Safecast/bGeigieCast/images/quick_start_guide/module_config_mode_led.png

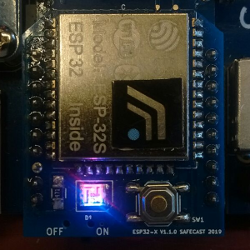
images/quick_start_guide/module_config_mode_led.png
