Safecast/bGeigieCast/images/quick_start_guide/module_initialized_led.png

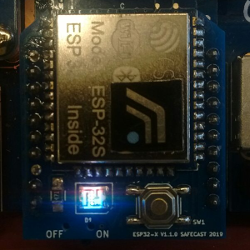
images/quick_start_guide/module_initialized_led.png
