Safecast/bGeigieCast/README.md

# bGeigieCast

An extension module to use your mobile bGeigieNano as a fixed sensor! 

User manual and other documentation on the Github Wiki:

* [User manual](https://github.com/Safecast/bGeigieCast/wiki/User-manual)
* [Quick start guide](https://github.com/Safecast/bGeigieCast/wiki/Quick-start-guide)
* [Set up your development environment](https://github.com/Safecast/bGeigieCast/wiki/Development-environment)
