Safecast/bGeigieCast/designs/hardware/bGeigieCast V1.6.0(StampS3)/bGeigieCast V1.6.0(StampS3)/Misc 3d files/m5-stamp-pico-1.snapshot.21/m5-stamp-pico-explode.png

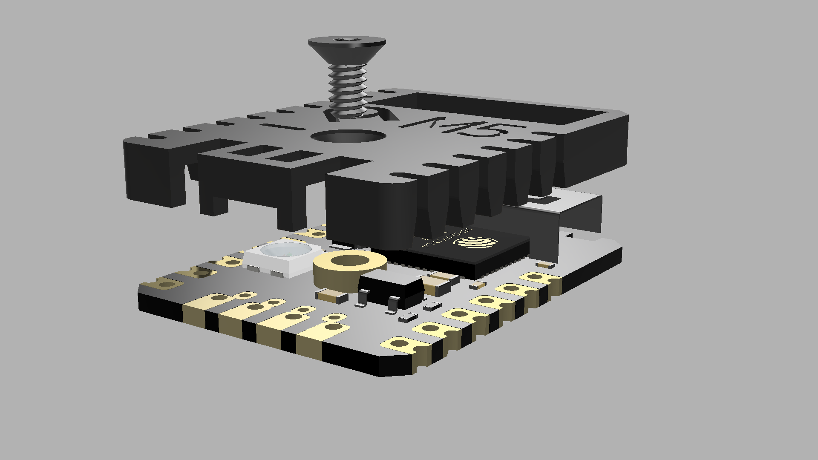
designs/hardware/bGeigieCast V1.6.0(StampS3)/bGeigieCast V1.6.0(StampS3)/Misc 3d files/m5-stamp-pico-1.snapshot.21/m5-stamp-pico-explode.png
