Safecast/bGeigieCast/designs/hardware/bGeigieCast V1.6.0(StampS3)/bGeigieCast V1.6.0(StampS3)/Misc 3d files/m5stamp-c3-1.snapshot.3/M5Stamp-C3.JPG

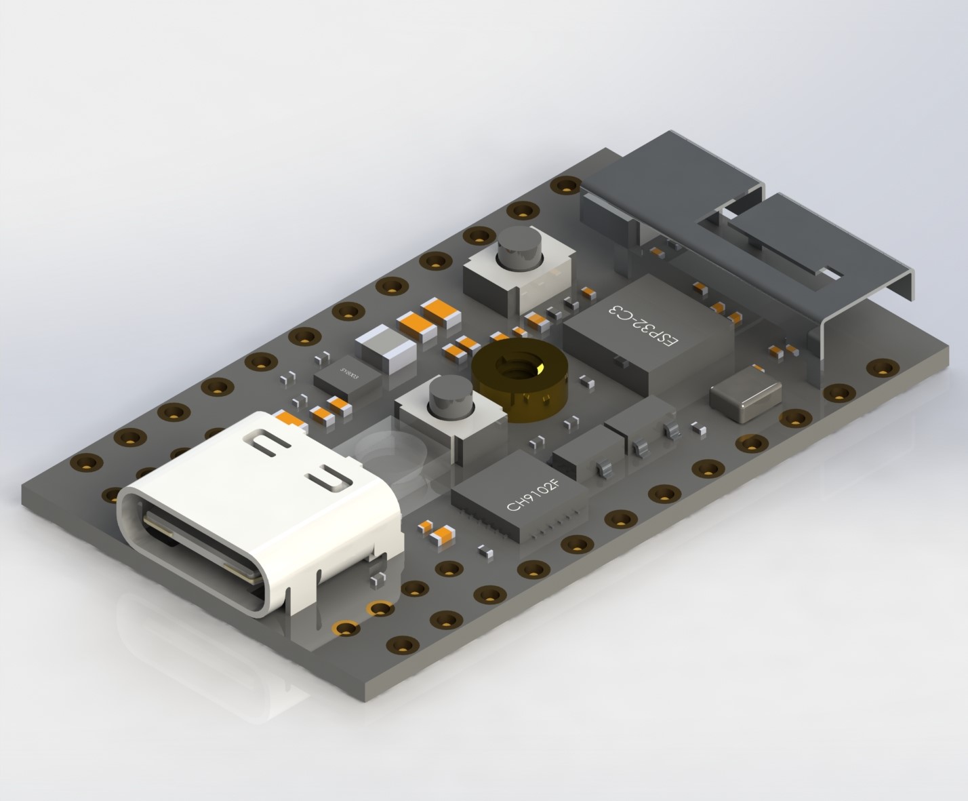
designs/hardware/bGeigieCast V1.6.0(StampS3)/bGeigieCast V1.6.0(StampS3)/Misc 3d files/m5stamp-c3-1.snapshot.3/M5Stamp-C3.JPG
