Safecast/bGeigieCast/designs/hardware/bGeigieCast V1.6.0(StampS3)/bGeigieCast V1.6.0(StampS3)/Misc 3d files/m5stamp-c3-1.snapshot.3/Schematic, M5Stamp C3.PNG

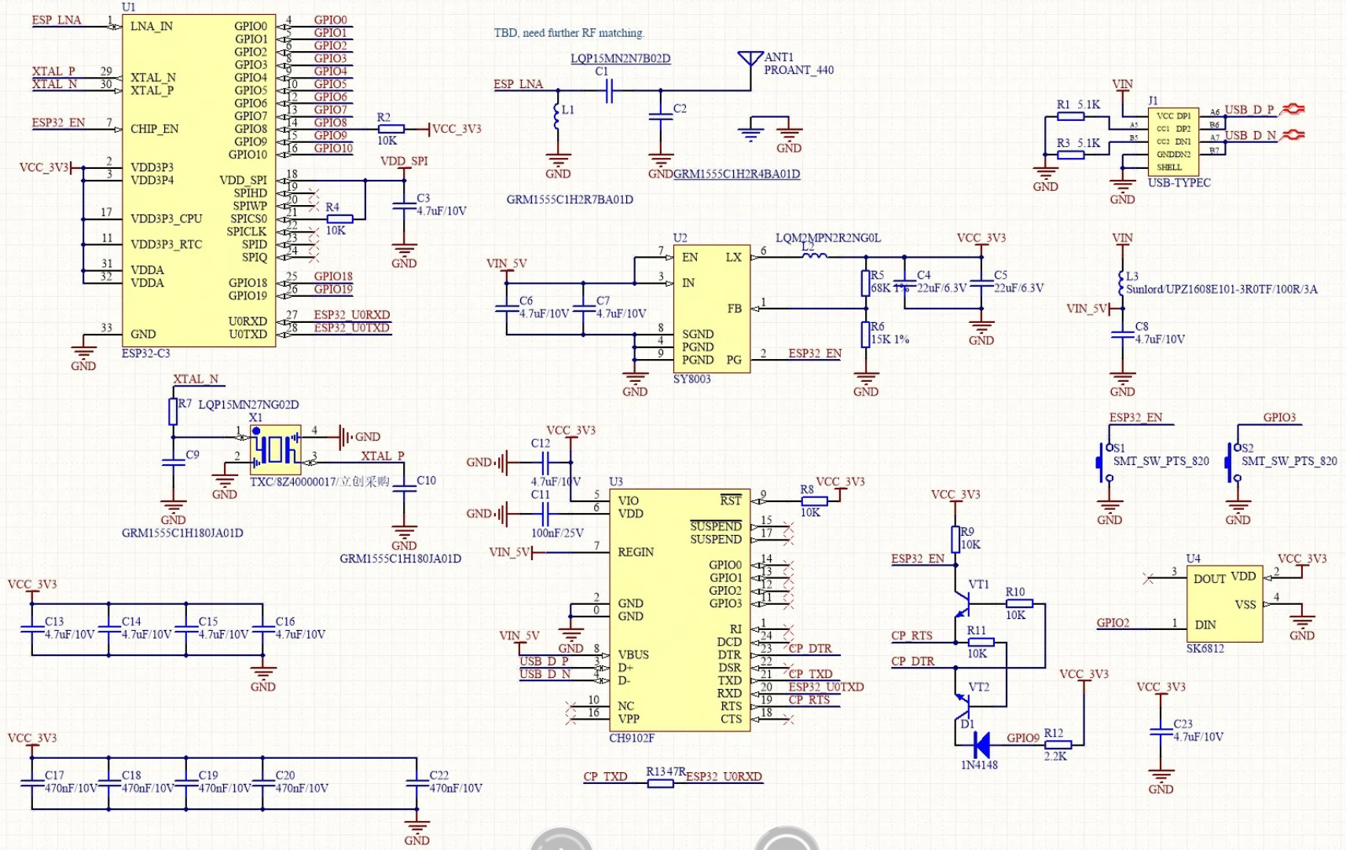
designs/hardware/bGeigieCast V1.6.0(StampS3)/bGeigieCast V1.6.0(StampS3)/Misc 3d files/m5stamp-c3-1.snapshot.3/Schematic, M5Stamp C3.PNG
