Safecast/bGeigieCast/designs/software/api-connector-states.png

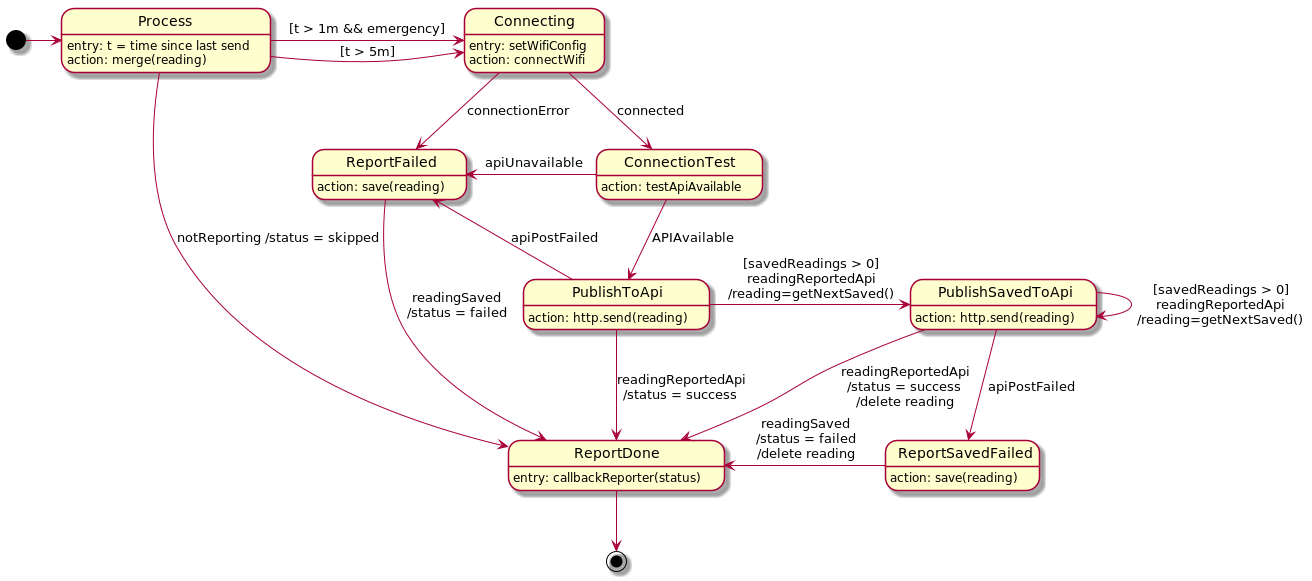
designs/software/api-connector-states.png
