Safecast/bGeigieCast/designs/software/controller-states.png

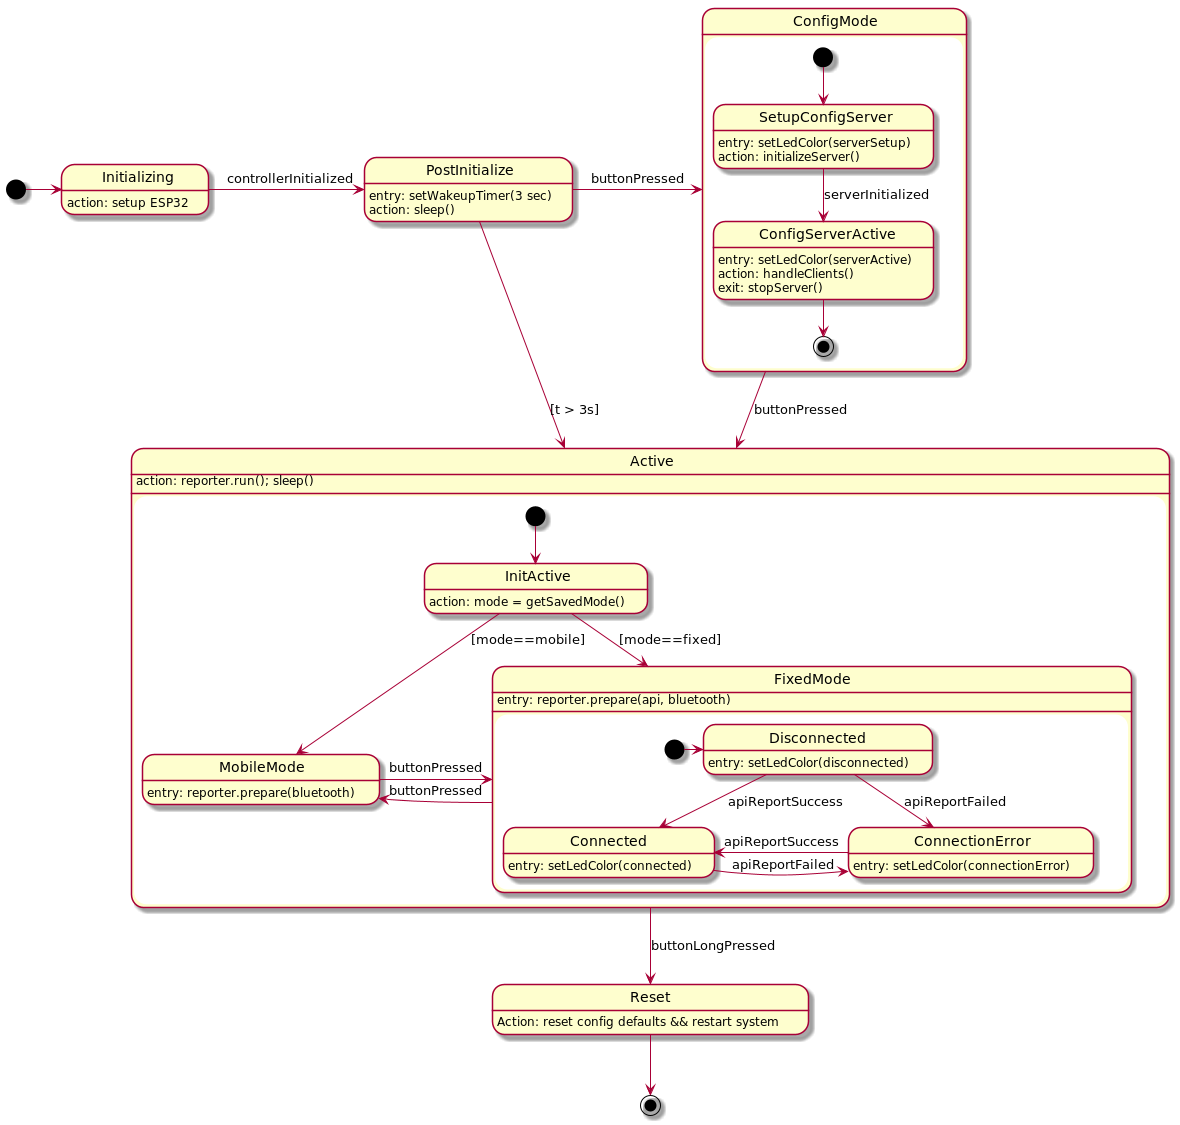
designs/software/controller-states.png
