Safecast/bGeigieCast/designs/software/process-data.png

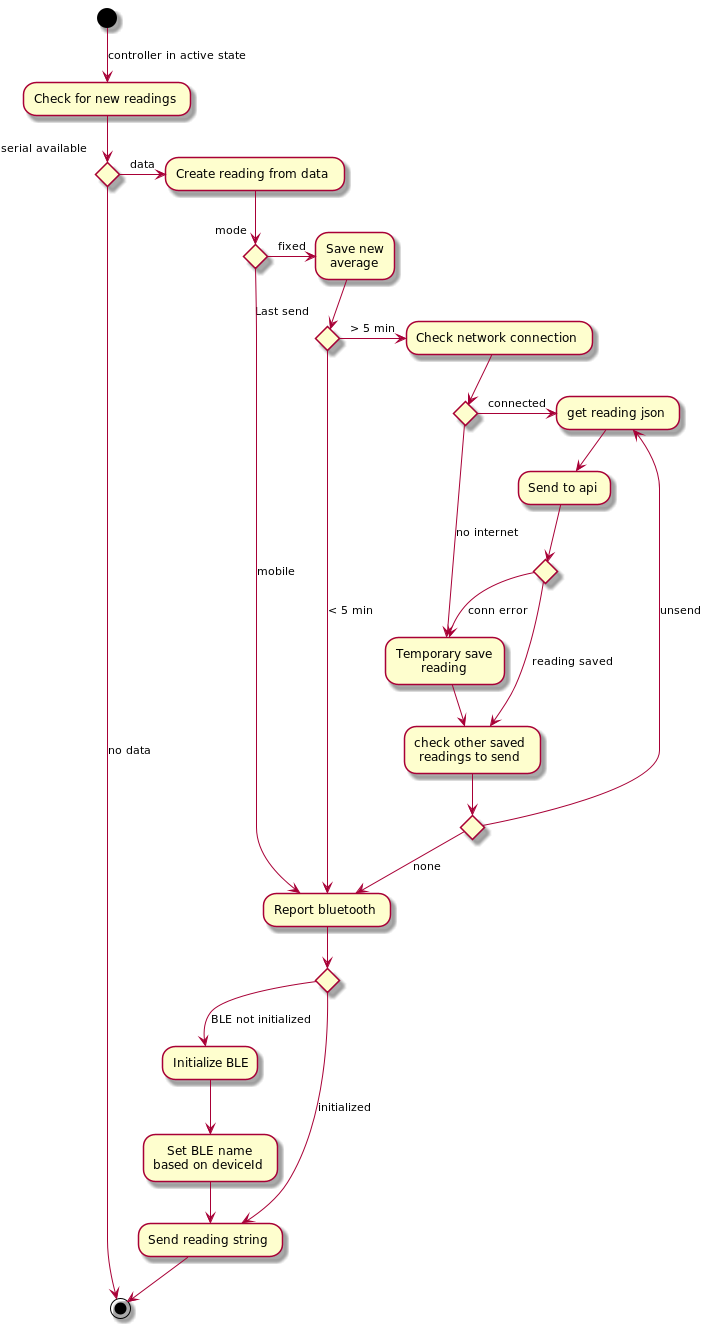
designs/software/process-data.png
