Safecast/bGeigieCast/designs/software/reporter-states.png

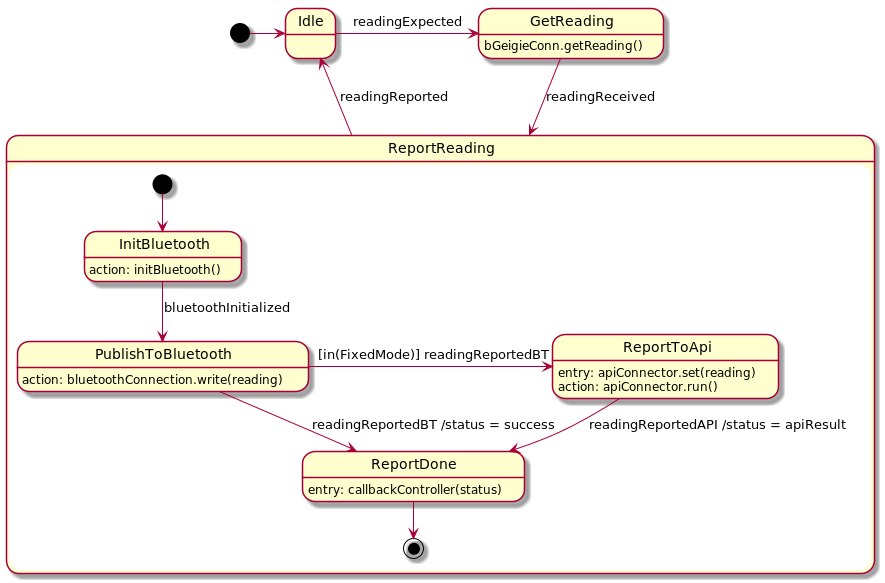
designs/software/reporter-states.png
