Safecast/bGeigieCast/designs/software/usecase.png

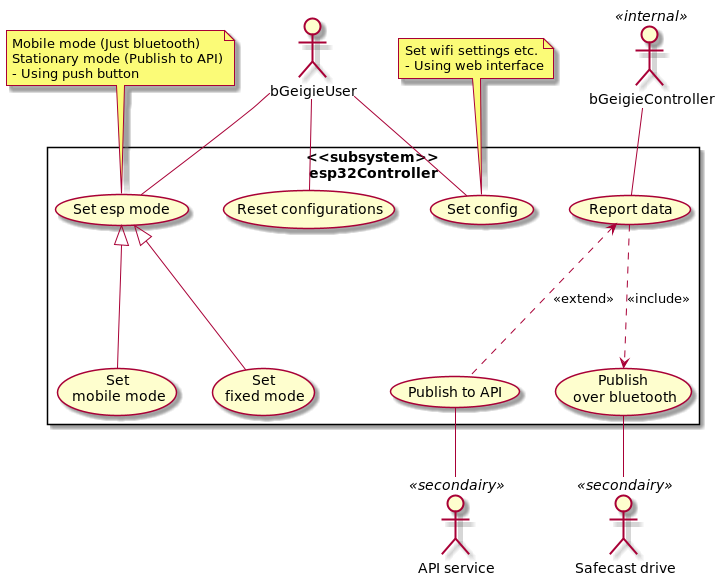
designs/software/usecase.png
