Safecast/bGeigieCast/images/module/LED-error.png

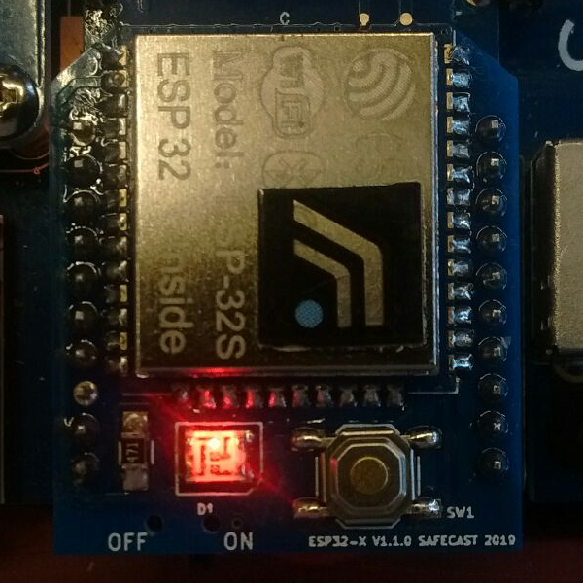
images/module/LED-error.png
