Safecast/bGeigieCast/images/module/mode-flow.png

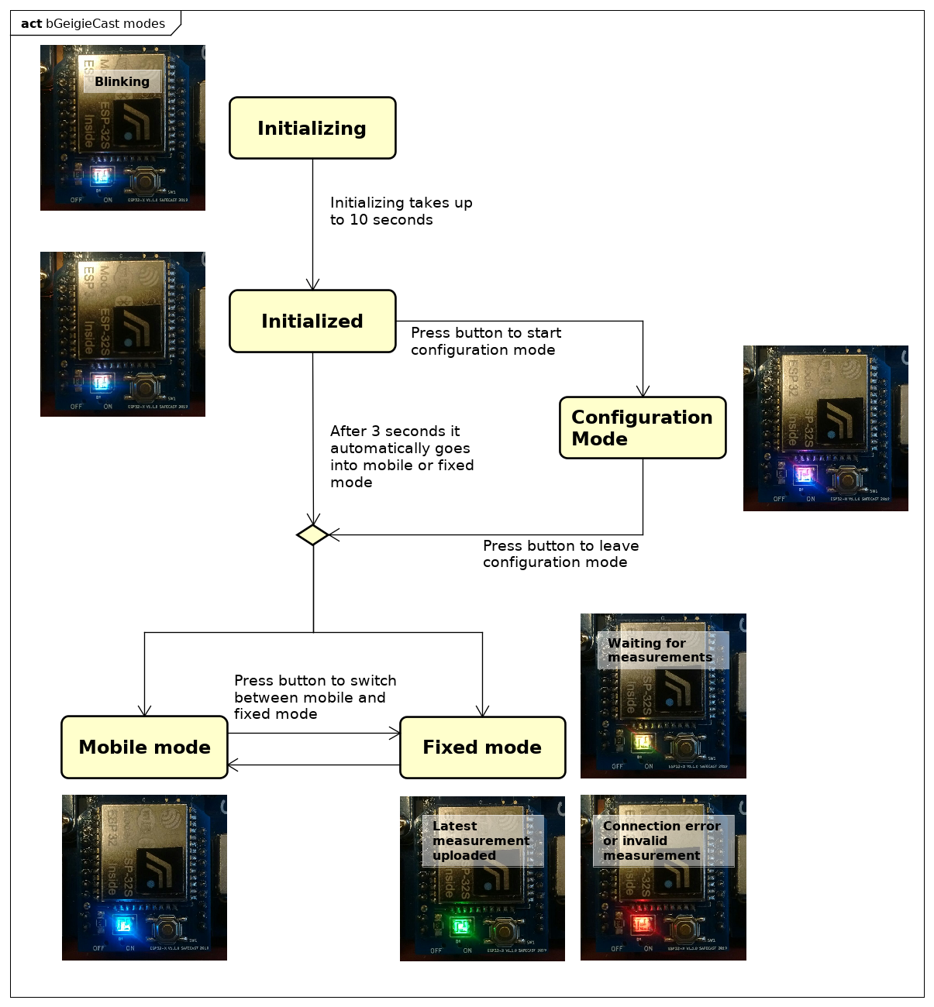
images/module/mode-flow.png
