Safecast/bGeigieCast/images/module/module.png

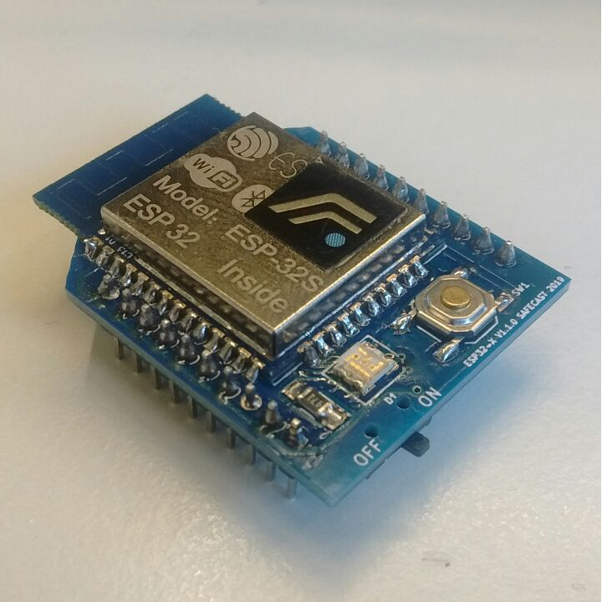
images/module/module.png
