Safecast/bGeigieCast/images/wiki/wireless charger dock.jpg

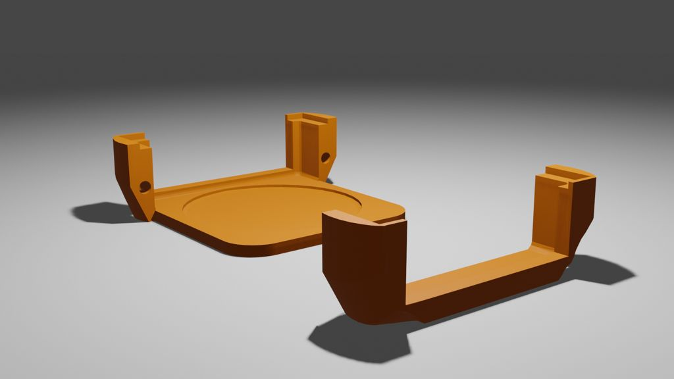
images/wiki/wireless charger dock.jpg
