Safecast/bGeigieCast/images/wiki/xbee_adapter.jpeg

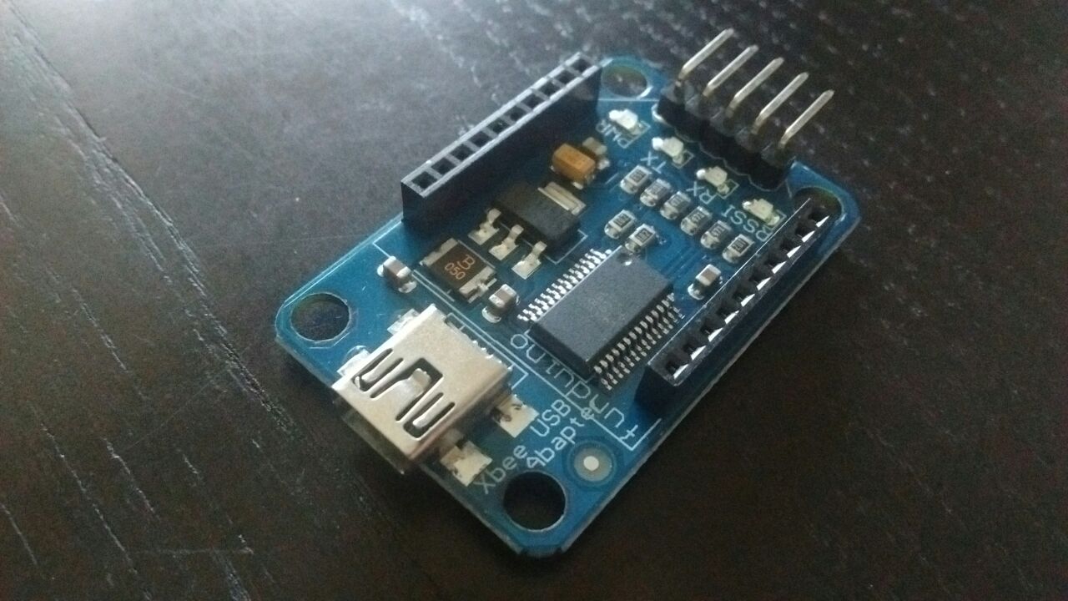
images/wiki/xbee_adapter.jpeg
