Safecast/bGeigieCast/designs/hardware/bGeigieCast V1.6.0(StampS3)/bGeigieCast V1.6.0(StampS3)/BOM bGeigieCast.xlsx

Id | Designator | Package | Quantity | Designation |  | Supplier and ref | URL | alt URL
6 | C1 | CP_EIA-6032-15_Kemet-U_Pad2.25x2.35mm_HandSolder | 1 | CP1 | 330uF 15V |  | https://www.ebay.com/itm/322335558548
2 | D1 | DJS-BRGBC-TR8 | 1 | RGB-LED | Common cathode |  | https://www.sparkfun.com/products/7844
8 | G*** | QR_code_safecast_bgc | 1 | LOGO
7 | R1,R3,R4 | R_0805_HandSoldering | 3 |  | 470 |  | https://www.amazon.com/470-ohm-Resistor-Resistors-Tolerance/dp/B07DHGBR3W | https://www.amazon.com/HiLetgo-Values-Resistors-Assortment-Resistor/dp/B07R5S5RFK
1 | SW1 | SW_SPST_TL3342 | 1 | TACT-SWITCH |  |  | https://www.digikey.com/en/products/detail/e-switch/TL3342F160QG-TR/379003
5 | SW2 | SW_SPDT_PCM12 | 1 | SWITCH_INV |  |  | https://www.digikey.com/en/products/detail/c-k/PCM12SMTR/1640112?s=N4IgTCBcDaIMoAUAiAVABAgwgWQIwQF0BfIA
4 | U1 | ESP-32S | 1 | ESP32S |  |  | https://www.digikey.com/en/products/detail/espressif-systems/esp32-wrover-b/9682051
3 | U2 | XBEE-20_THT | 1 | XBEE-socket | 2x10 2mm pitch |  | https://www.sparkfun.com/products/10112
