Safecast/bGeigieCast/designs/hardware/bGeigieCast V1.6.0(StampS3)/bGeigieCast V1.6.0(StampS3)/BOM bGeigieCast.xls

Id | Designator | Manufacturer Part Number or Seeed SKU | Quantity | Designation | Supplier and ref
1 | C1 | CP_EIA-6032-15_Kemet-U_Pad2.25x2.35mm_HandSolder | 1 | CP1
2 | R4,R3,R1 | R_0805_HandSoldering | 3 | 470
3 | U2 | XBEE-20_THT | 1 | XBEE-socket
4 | D1 | DJS-BRGBC-TR8 | 1 | RGB-LED
5 | U1 | ESP-32S | 1 | ESP32S
6 | SW2 | SW_SPDT_PCM12 | 1 | SWITCH_INV
7 | SW1 | SW_SPST_TL3342 | 1 | TACT-SWITCH
