Safecast/bGeigieCast/designs/hardware/bGeigieCast V1.6.0(StampS3)/bGeigieCast V1.6.0(StampS3)/xbee BOM.xlsx

bGeigieCast V1.4.0 BOM
Id | Designator | Package | Quantity | Designation | Supplier and ref | Price Japan | Subtotal | URL
1 | G*** | QR_code_safecast_bgc | 1 | LOGO |  |  | ￥0
2 | C1 | CP_Tantalum_Case-D_EIA-7343-31_Reflow | 1 | CP1 |  | ￥37 | ￥37 | https://www.ebay.com/itm/322335558548
3 | R4,R3,R1 | R_0805_HandSoldering | 3 | 470 |  | ￥1 | ￥3 | https://amazon.co.jp/
4 | U2 | XBEE-20_THT | 2 | XBEE-pins | Mouser | ￥65 | ￥130 | https://www.mouser.com/ProductDetail/Harwin/M22-2511005
5 | D1 | DJS-BRGBC-TR8 | 1 | RGB-LED | Switch Science | ￥280 | ￥280 | https://www.switch-science.com/catalog/81/
6 | U1 | ESP-32S | 1 | ESP32S | Banggood | ￥510 | ￥510 | https://www.banggood.com/ESP32-S-WiFi-bluetooth-ESP32S-Serial-to-WiFi-Dual-Antenna-Module-p-1469255.html
7 | SW2 | SW_SPDT_PCM12 | 1 | SWITCH_INV | Digikey | ￥101 | ￥101 | https://www.digikey.com/product-detail/en/c-k/PCM12SMTR/401-2016-1-ND/1640125
8 | SW1 | SW_SPST_TL3342 | 1 | TACT-SWITCH |  | ￥70 | ￥70 | https://www.mouser.com/ProductDetail/E-Switch/TL3342F160QG?qs=6C6BR4UgC3N80rVVEktZJA%3D%3D
9 | Board | Dirty PCB 5x5 prototype gold | 1 |  |  | ￥540 | ￥540 | https://dirtypcbs.com/store/order/2055375/
 |  |  |  |  |  |  | ￥1671
