Safecast/bGeigieCast/designs/software/components.png

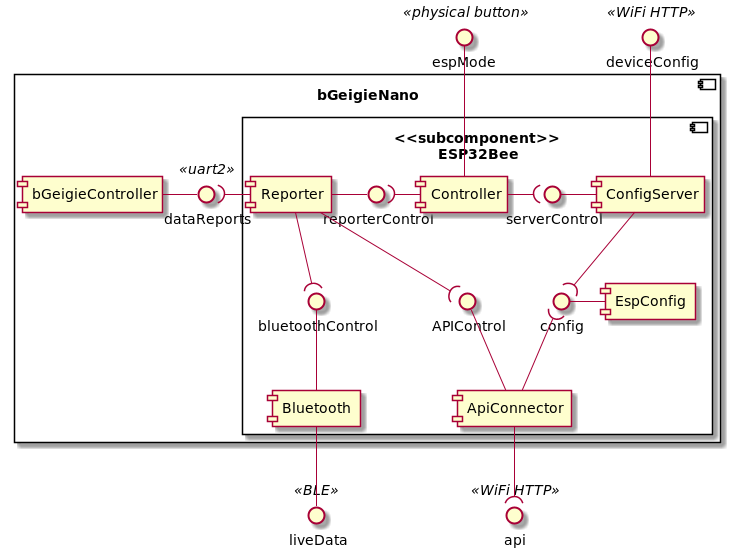
designs/software/components.png
