Safecast/bGeigieCast/designs/hardware/bGeigieCast V1.6.0(StampS3)/bGeigieCast V1.6.0(StampS3)/Misc 3d files/m5stamp-c3-1.snapshot.3/M5Stamp-C3.SLDASM

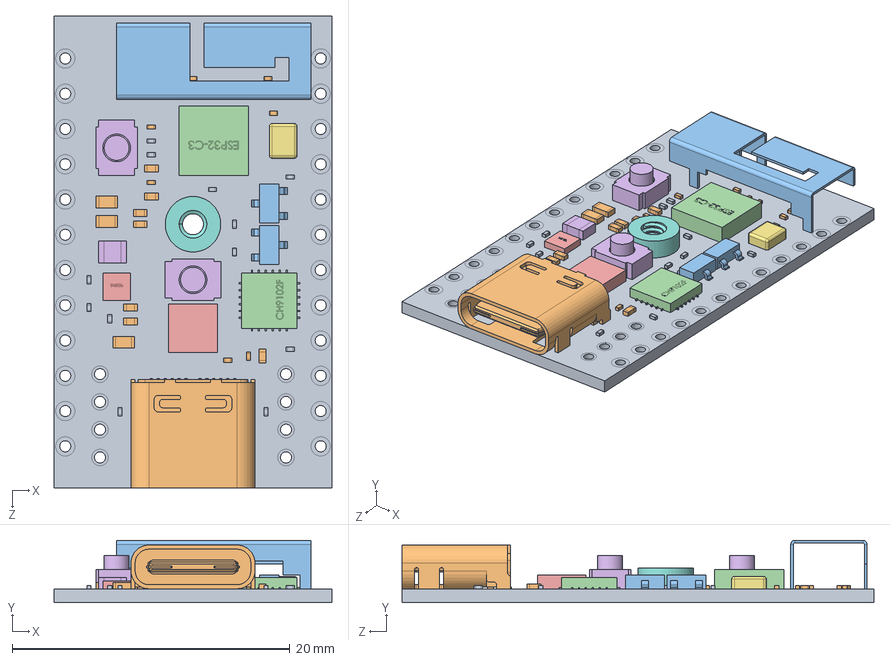
[picture p21: CAD file, 2023-09-07]
designs/hardware/bGeigieCast V1.6.0(StampS3)/bGeigieCast V1.6.0(StampS3)/Misc 3d files/m5stamp-c3-1.snapshot.3/M5Stamp-C3.SLDASM
20.0 x 4.50 x 34.0 mm
PCB, M5Stamp-C3
Female USB Type C Connector, M5Stamp-C3
ANT1, PRO-OB-440, M5Stamp-C3
ESP32C3 Microcontroller, M5Stamp-C3
LED, M5Stamp-C3
Momentary Tactile Push Button, M5Stamp-C3 x 2
8Z40000017, TXC, Crystal Resonator, 40 MHz, M5Stamp C3
Fastening Press Fit Nut, M5Stamp-C3
SMD Resistor, Configurable, M5Stamp-C3 x 12
SMD Capacitor, Configurable, M5Stamp-C3 x 23
SMD Transistor, M5Stamp-C3 x 2
CH9102F, USB Serial Port Chip, M5Stamp C3
SY8003, Step-Down DC-DC Regulator, M5Stamp-C3
Large SMD Component, Configurable, M5Stamp-C3
