Safecast/bGeigieCast/designs/hardware/bGeigieCast V1.6.0(StampS3)/bGeigieCast V1.6.0(StampS3)/bGeigieCast V1.6.0(StampS3).step

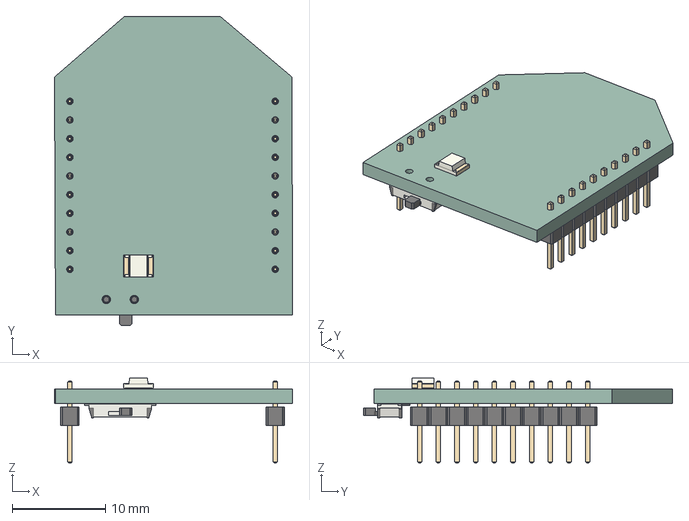
[picture p22: CAD file, 2023-07-28]
designs/hardware/bGeigieCast V1.6.0(StampS3)/bGeigieCast V1.6.0(StampS3)/bGeigieCast V1.6.0(StampS3).step
25.5 x 33.1 x 9.10 mm
bGeigieCast V1.6.0(StampS3)_PCB
