Safecast/bGeigieCast/designs/hardware/bGeigieCast V1.6.0(StampS3)/bGeigieCast V1.6.0(StampS3)/Misc 3d files/m5stamp-c3-1.snapshot.3/ANT1, PRO-OB-440, M5Stamp-C3.SLDPRT

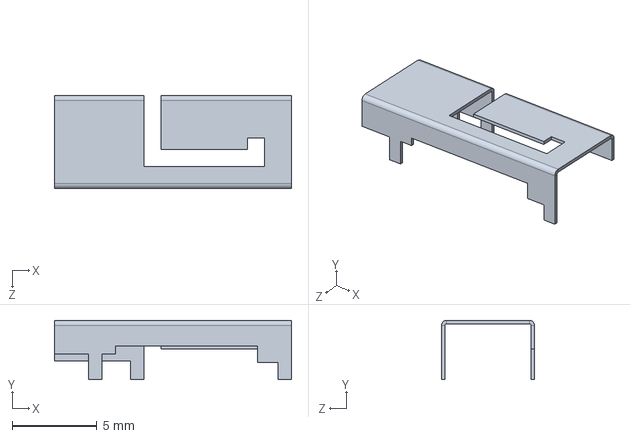
[picture p23: CAD file, 2023-09-07]
designs/hardware/bGeigieCast V1.6.0(StampS3)/bGeigieCast V1.6.0(StampS3)/Misc 3d files/m5stamp-c3-1.snapshot.3/ANT1, PRO-OB-440, M5Stamp-C3.SLDPRT
14.0 x 3.50 x 5.50 mm
