Safecast/bGeigieCast/designs/hardware/bGeigieCast V1.6.0(StampS3)/bGeigieCast V1.6.0(StampS3)/shapes3D/ESP-12_4wings.stl

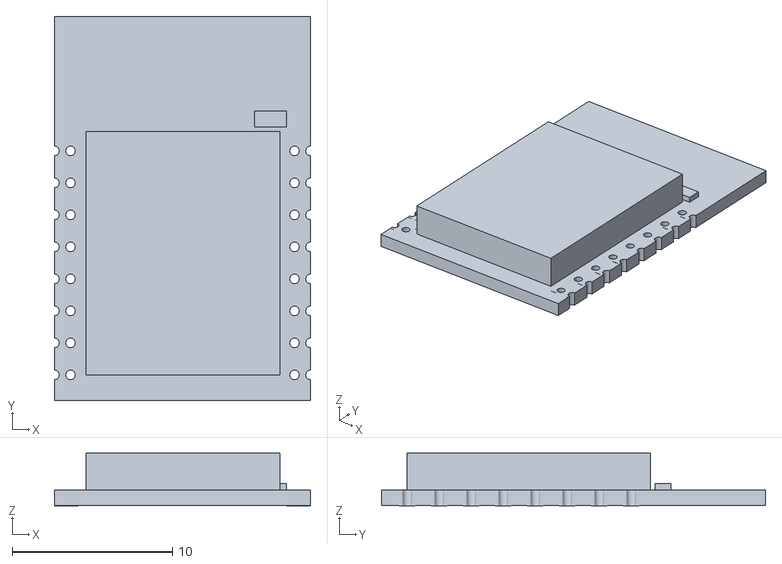
[picture p24: CAD file, 2023-07-28]
designs/hardware/bGeigieCast V1.6.0(StampS3)/bGeigieCast V1.6.0(StampS3)/shapes3D/ESP-12_4wings.stl
16.0 x 24.0 x 3.30
