Safecast/bGeigieCast/designs/hardware/bGeigieCast V1.6.0(StampS3)/bGeigieCast V1.6.0(StampS3)/Misc 3d files/m5stamp-c3-1.snapshot.3/Unnamed-M5Stamp-C3Female USB Type C Connector, M5Stamp-C3.step

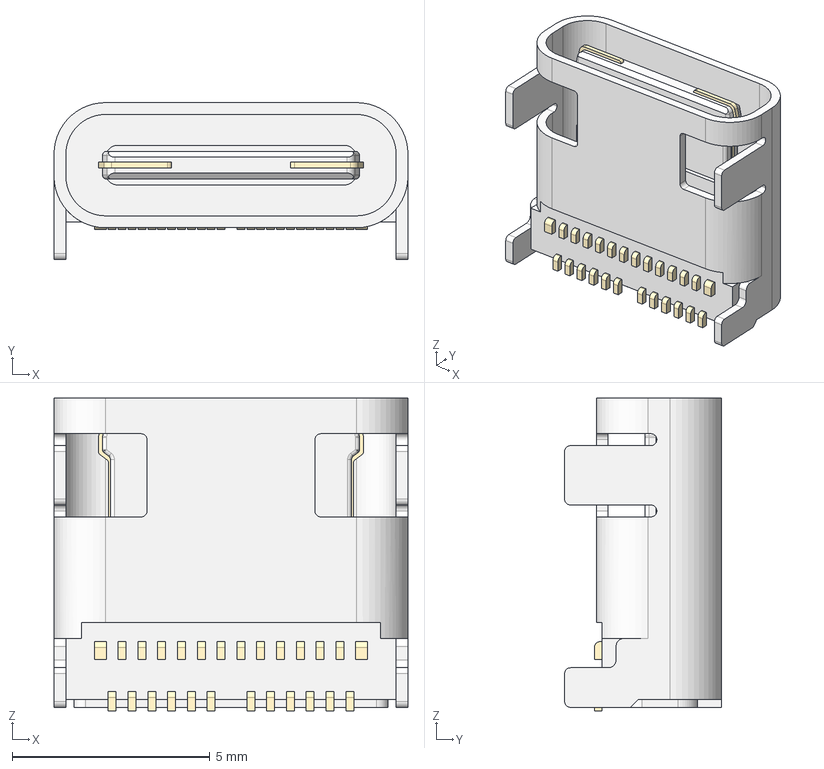
[picture p25: CAD file, 2023-09-07]
designs/hardware/bGeigieCast V1.6.0(StampS3)/bGeigieCast V1.6.0(StampS3)/Misc 3d files/m5stamp-c3-1.snapshot.3/Unnamed-M5Stamp-C3Female USB Type C Connector, M5Stamp-C3.step
8.94 x 3.96 x 7.90 mm
