Safecast/bGeigieCast/designs/hardware/bGeigieCast V1.6.0(StampS3)/bGeigieCast V1.6.0(StampS3)/shapes3D/ESP-13-wroom-02.stl

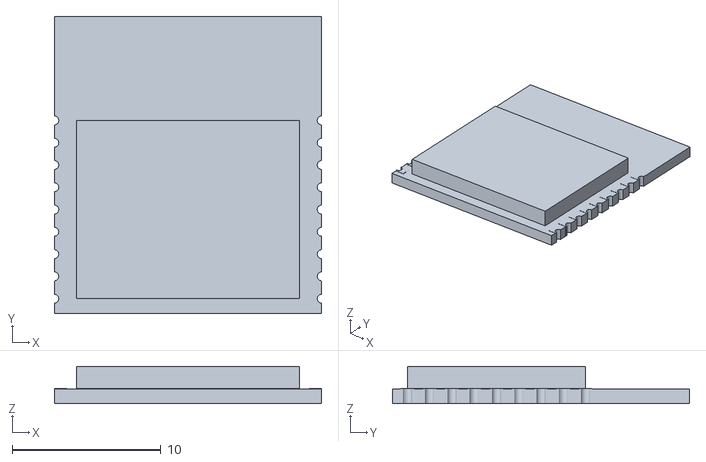
[picture p26: CAD file, 2023-07-28]
designs/hardware/bGeigieCast V1.6.0(StampS3)/bGeigieCast V1.6.0(StampS3)/shapes3D/ESP-13-wroom-02.stl
18.0 x 20.0 x 2.50
