Safecast/bGeigieCast/designs/hardware/bGeigieCast V1.6.0(StampS3)/bGeigieCast V1.6.0(StampS3)/xbee1.step

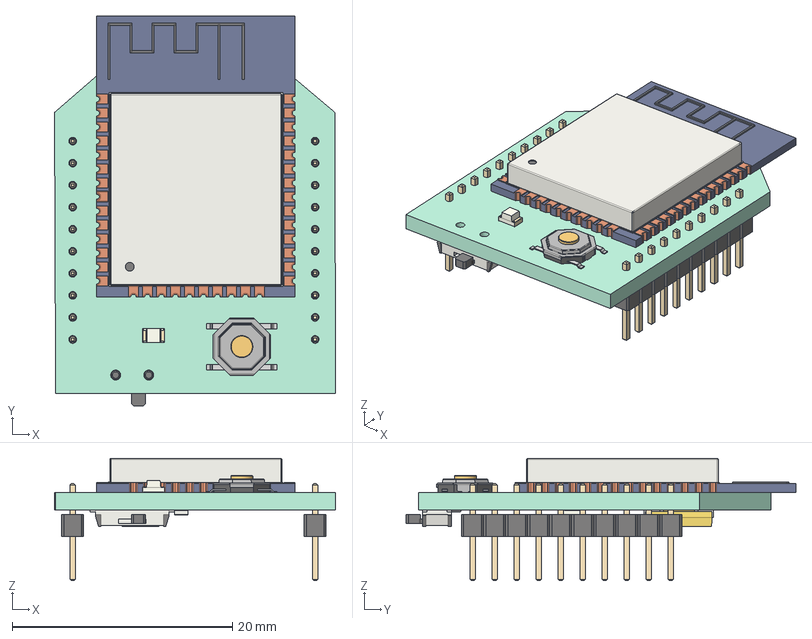
[picture p27: CAD file, 2021-06-23]
designs/hardware/bGeigieCast V1.6.0(StampS3)/bGeigieCast V1.6.0(StampS3)/xbee1.step
25.5 x 35.4 x 11.1 mm
Local_CS_fa61
Pcb_fa61 x 2
SW1_SW_SPST_TL3342_00005c6e873a[2] x 3
D1_LED_0805_2012Metric_00005cd0f46f x 3
U2_PinHeader_1x10_P200mm_Vertical_00005cd3e61b x 6
U1_ESP32-WROOM-32_00005cd3e70f[2] x 3
SW2_Fusion_sp_00005c70e934[2] x 3
C1_CP_EIA_6032_15_Kemet_U_00005cc7db3b x 3
R1_R_0805_2012Metric_00005ce61967[2] x 9
