Safecast/bGeigieCast/designs/hardware/bGeigieCast V1.6.0(StampS3)/bGeigieCast V1.6.0(StampS3)/bGeigiecast.FCStd

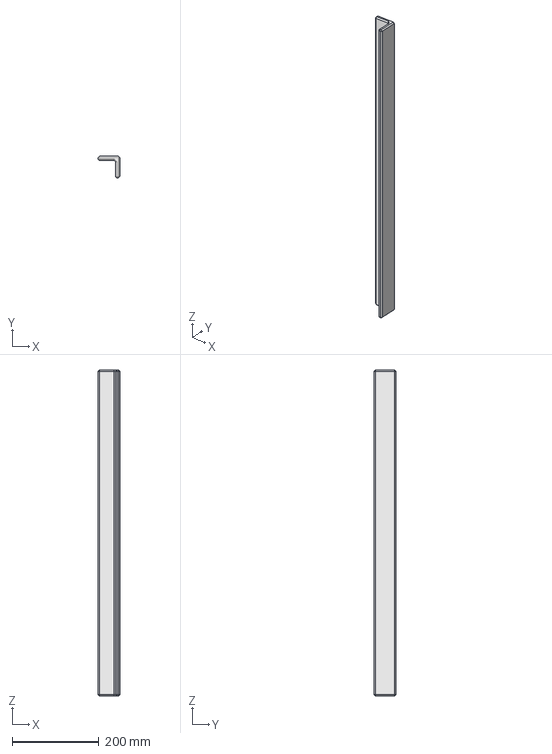
[picture p28: CAD file, 2020-10-03]
designs/hardware/bGeigieCast V1.6.0(StampS3)/bGeigieCast V1.6.0(StampS3)/bGeigiecast.FCStd
50.0 x 50.0 x 750.0 mm
