Safecast/bGeigieCast/designs/hardware/bGeigieCast V1.6.0(StampS3)/bGeigieCast V1.6.0(StampS3)/Misc 3d files/m5stamp-c3-1.snapshot.3/SY8003, Step-Down DC-DC Regulator, M5Stamp-C3.SLDPRT

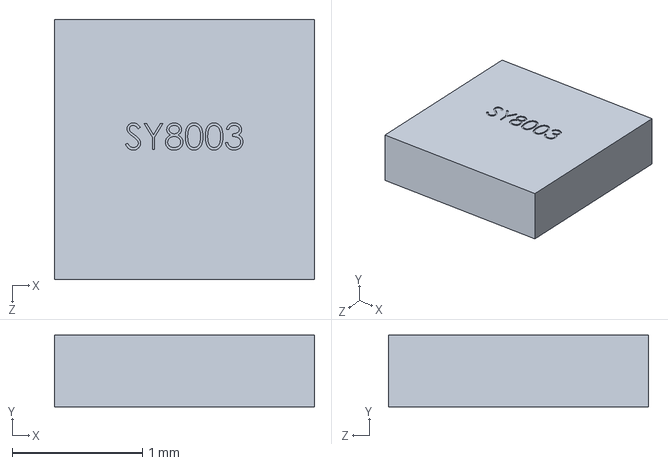
[picture p29: CAD file, 2023-09-07]
designs/hardware/bGeigieCast V1.6.0(StampS3)/bGeigieCast V1.6.0(StampS3)/Misc 3d files/m5stamp-c3-1.snapshot.3/SY8003, Step-Down DC-DC Regulator, M5Stamp-C3.SLDPRT
2.00 x 0.55 x 2.00 mm
