Safecast/bGeigieCast/designs/hardware/bGeigieCast V1.6.0(StampS3)/bGeigieCast V1.6.0(StampS3)/shapes3D/ESP-07v2.stl

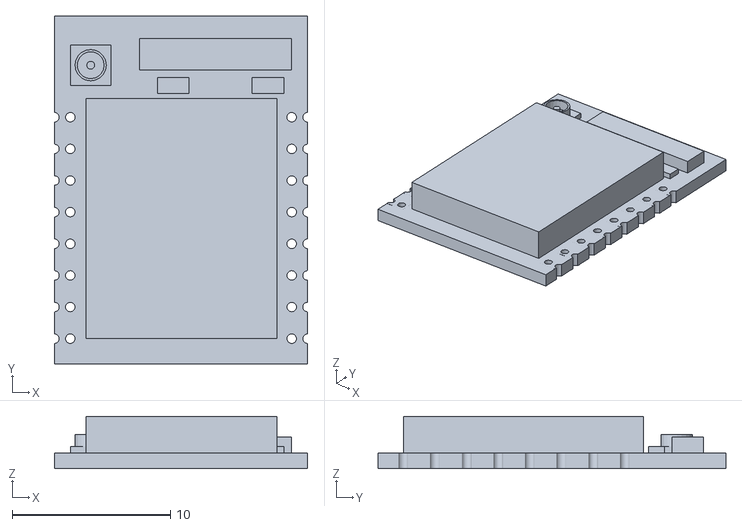
[picture p30: CAD file, 2023-07-28]
designs/hardware/bGeigieCast V1.6.0(StampS3)/bGeigieCast V1.6.0(StampS3)/shapes3D/ESP-07v2.stl
16.0 x 22.0 x 3.30
