Safecast/bGeigieCast/designs/hardware/bGeigieCast V1.6.0(StampS3)/bGeigieCast V1.6.0(StampS3)/Misc 3d files/m5stamp-c3-1.snapshot.3/PCB, M5Stamp-C3.SLDPRT

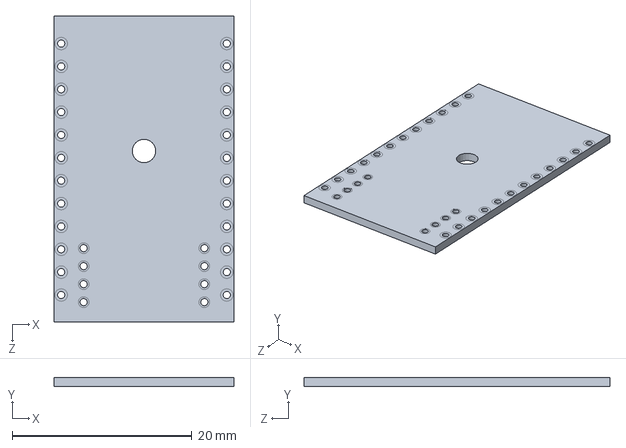
[picture p31: CAD file, 2023-09-07]
designs/hardware/bGeigieCast V1.6.0(StampS3)/bGeigieCast V1.6.0(StampS3)/Misc 3d files/m5stamp-c3-1.snapshot.3/PCB, M5Stamp-C3.SLDPRT
20.0 x 1.00 x 34.0 mm
