Safecast/bGeigieCast/designs/hardware/bGeigieCast V1.6.0(StampS3)/bGeigieCast V1.6.0(StampS3)/Misc 3d files/m5stamp-c3-1.snapshot.3/ESP32­C3 Microcontroller, M5Stamp-C3.SLDPRT

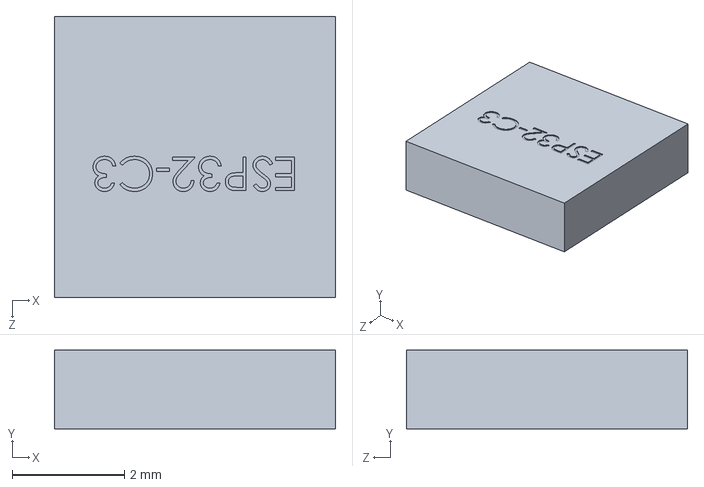
[picture p32: CAD file, 2023-09-07]
designs/hardware/bGeigieCast V1.6.0(StampS3)/bGeigieCast V1.6.0(StampS3)/Misc 3d files/m5stamp-c3-1.snapshot.3/ESP32­C3 Microcontroller, M5Stamp-C3.SLDPRT
5.00 x 1.40 x 5.00 mm
