Safecast/bGeigieCast/designs/hardware/bGeigieCast V1.6.0(StampS3)/bGeigieCast V1.6.0(StampS3)/Misc 3d files/m5stamp-c3-1.snapshot.3/Fastening Press Fit Nut, M5Stamp-C3.SLDPRT

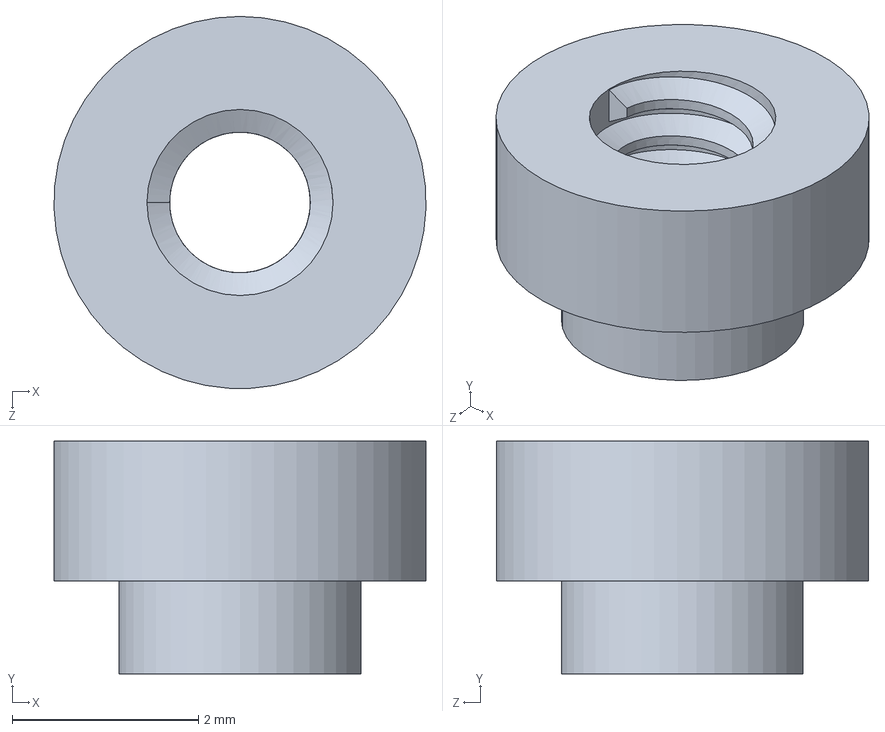
[picture p33: CAD file, 2023-09-07]
designs/hardware/bGeigieCast V1.6.0(StampS3)/bGeigieCast V1.6.0(StampS3)/Misc 3d files/m5stamp-c3-1.snapshot.3/Fastening Press Fit Nut, M5Stamp-C3.SLDPRT
4.00 x 2.50 x 4.00 mm
