Safecast/bGeigieCast/designs/hardware/bGeigieCast V1.6.0(StampS3)/bGeigieCast V1.6.0(StampS3)/Misc 3d files/m5stamp-c3-1.snapshot.3/Large SMD Component, Configurable, M5Stamp-C3.SLDPRT

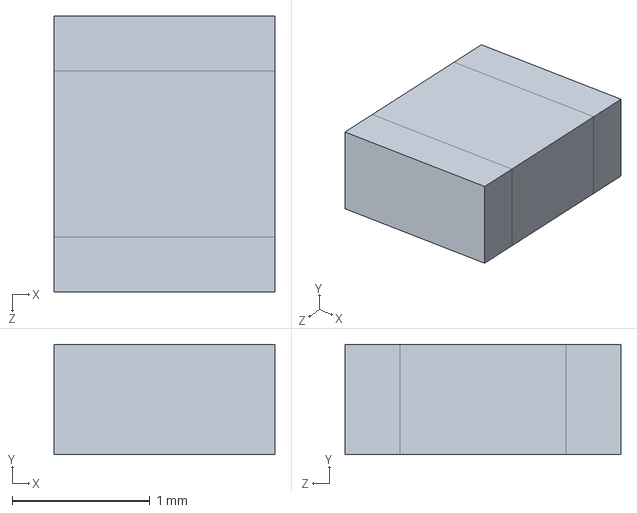
[picture p34: CAD file, 2023-09-07]
designs/hardware/bGeigieCast V1.6.0(StampS3)/bGeigieCast V1.6.0(StampS3)/Misc 3d files/m5stamp-c3-1.snapshot.3/Large SMD Component, Configurable, M5Stamp-C3.SLDPRT
1.60 x 0.8 x 2.00 mm
