Safecast/bGeigieCast/designs/hardware/bGeigieCast V1.6.0(StampS3)/bGeigieCast V1.6.0(StampS3)/Misc 3d files/m5stamp-c3-1.snapshot.3/M5satck Stamp C3.FCStd

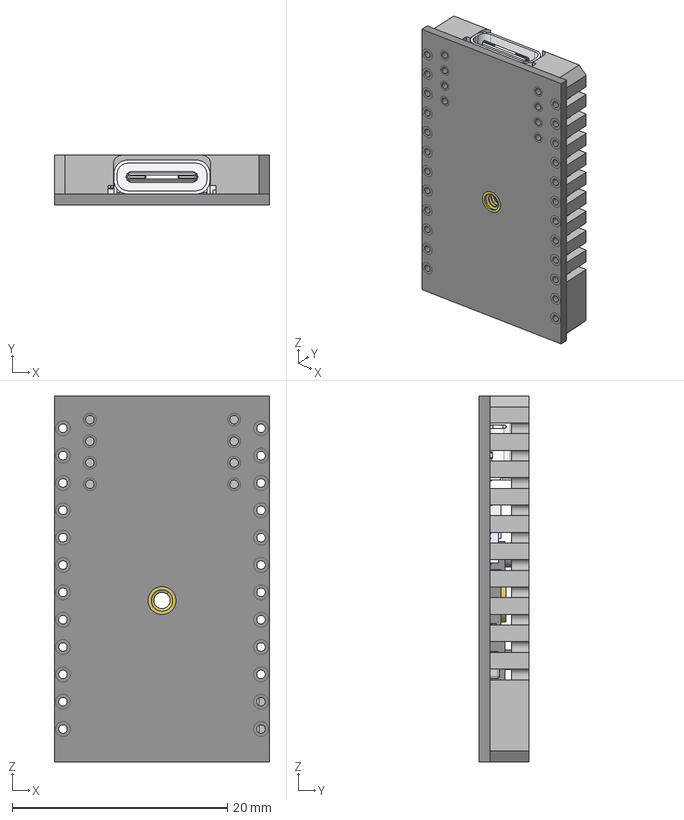
[picture p35: CAD file, 2023-09-07]
designs/hardware/bGeigieCast V1.6.0(StampS3)/bGeigieCast V1.6.0(StampS3)/Misc 3d files/m5stamp-c3-1.snapshot.3/M5satck Stamp C3.FCStd
20.0 x 4.60 x 34.0 mm
PCB, M5Stamp-C3
Female USB Type C Connector, M5Stamp-C3
ANT1, PRO-OB-440, M5Stamp-C3
ESP32C3 Microcontroller, M5Stamp-C3
LED, M5Stamp-C3
Momentary Tactile Push Button, M5Stamp-C3_S1
Momentary Tactile Push Button, M5Stamp-C3_S2
8Z40000017, TXC, Crystal Resonator, 40 MHz, M5Stamp C3
Fastening Press Fit Nut, M5Stamp-C3
SMD Resistor, Configurable, M5Stamp-C3_R1
SMD Resistor, Configurable, M5Stamp-C3_R002
SMD Resistor, Configurable, M5Stamp-C3_R003
SMD Capacitor, Configurable, M5Stamp-C3_C1
SMD Capacitor, Configurable, M5Stamp-C3_C002
SMD Capacitor, Configurable, M5Stamp-C3_C003
SMD Resistor, Configurable, M5Stamp-C3_R3
SMD Resistor, Configurable, M5Stamp-C3_R005
SMD Resistor, Configurable, M5Stamp-C3_R006
SMD Resistor, Configurable, M5Stamp-C3_R4
SMD Resistor, Configurable, M5Stamp-C3_R008
SMD Resistor, Configurable, M5Stamp-C3_R009
SMD Resistor, Configurable, M5Stamp-C3_R7
SMD Resistor, Configurable, M5Stamp-C3_R011
SMD Resistor, Configurable, M5Stamp-C3_R012
SMD Resistor, Configurable, M5Stamp-C3_R6
SMD Resistor, Configurable, M5Stamp-C3_R014
SMD Resistor, Configurable, M5Stamp-C3_R015
SMD Resistor, Configurable, M5Stamp-C3_R5
SMD Resistor, Configurable, M5Stamp-C3_R017
SMD Resistor, Configurable, M5Stamp-C3_R018
SMD Resistor, Configurable, M5Stamp-C3_R8
SMD Resistor, Configurable, M5Stamp-C3_R020
SMD Resistor, Configurable, M5Stamp-C3_R021
SMD Resistor, Configurable, M5Stamp-C3_R2
SMD Resistor, Configurable, M5Stamp-C3_R023
SMD Resistor, Configurable, M5Stamp-C3_R024
SMD Resistor, Configurable, M5Stamp-C3_R9
SMD Resistor, Configurable, M5Stamp-C3_R026
SMD Resistor, Configurable, M5Stamp-C3_R027
SMD Resistor, Configurable, M5Stamp-C3_R029
SMD Resistor, Configurable, M5Stamp-C3_R030
SMD Resistor, Configurable, M5Stamp-C3_R031
SMD Capacitor, Configurable, M5Stamp-C3_C5
SMD Capacitor, Configurable, M5Stamp-C3_C005
SMD Capacitor, Configurable, M5Stamp-C3_C006
SMD Capacitor, Configurable, M5Stamp-C3_C6
SMD Capacitor, Configurable, M5Stamp-C3_C008
SMD Capacitor, Configurable, M5Stamp-C3_C009
SMD Capacitor, Configurable, M5Stamp-C3_C7
SMD Capacitor, Configurable, M5Stamp-C3_C011
SMD Capacitor, Configurable, M5Stamp-C3_C012
SMD Capacitor, Configurable, M5Stamp-C3_C8
SMD Capacitor, Configurable, M5Stamp-C3_C014
SMD Capacitor, Configurable, M5Stamp-C3_C015
SMD Capacitor, Configurable, M5Stamp-C3_C9
SMD Capacitor, Configurable, M5Stamp-C3_C017
SMD Capacitor, Configurable, M5Stamp-C3_C018
SMD Capacitor, Configurable, M5Stamp-C3_C10
SMD Capacitor, Configurable, M5Stamp-C3_C020
SMD Capacitor, Configurable, M5Stamp-C3_C021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
