Safecast/bGeigieCast/designs/hardware/bGeigieCast V1.6.0(StampS3)/bGeigieCast V1.6.0(StampS3)/Misc 3d files/m5stamp-c3-1.snapshot.3/8Z40000017, TXC, Crystal Resonator, 40 MHz, M5Stamp C3.SLDPRT

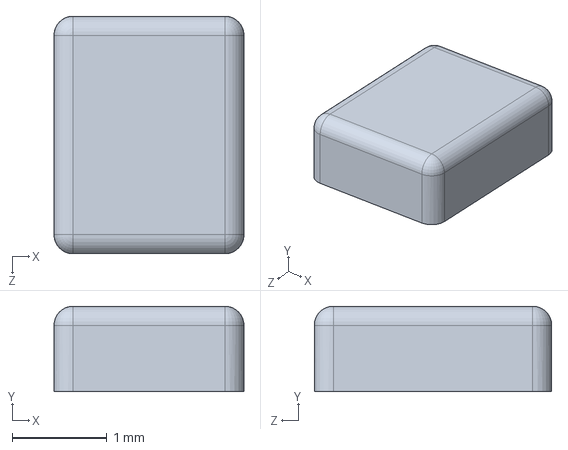
[picture p38: CAD file, 2023-09-07]
designs/hardware/bGeigieCast V1.6.0(StampS3)/bGeigieCast V1.6.0(StampS3)/Misc 3d files/m5stamp-c3-1.snapshot.3/8Z40000017, TXC, Crystal Resonator, 40 MHz, M5Stamp C3.SLDPRT
2.00 x 0.9 x 2.50 mm
