Safecast/bGeigieCast/designs/hardware/bGeigieCast V1.6.0(StampS3)/bGeigieCast V1.6.0(StampS3)/Misc 3d files/m5stamp-c3-1.snapshot.3/SMD Capacitor, Configurable, M5Stamp-C3.SLDPRT

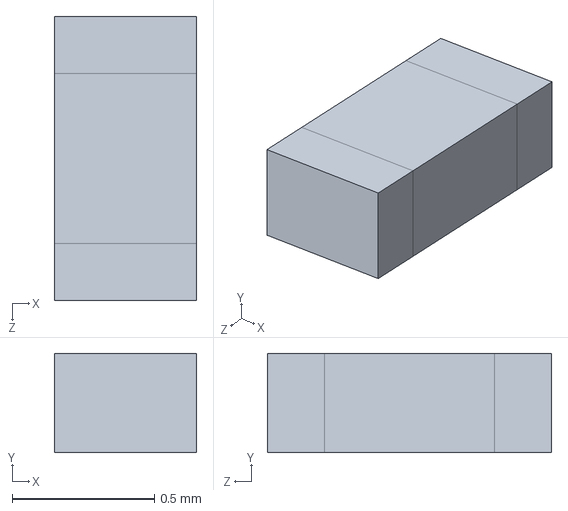
[picture p44: CAD file, 2023-09-07]
designs/hardware/bGeigieCast V1.6.0(StampS3)/bGeigieCast V1.6.0(StampS3)/Misc 3d files/m5stamp-c3-1.snapshot.3/SMD Capacitor, Configurable, M5Stamp-C3.SLDPRT
0.5 x 0.35 x 1.00 mm
