Safecast/bGeigieCast/designs/hardware/bGeigieCast V1.6.0(StampS3)/bGeigieCast V1.6.0(StampS3)/Misc 3d files/m5stamp-c3-1.snapshot.3/SMD Resistor, Configurable, M5Stamp-C3.SLDPRT

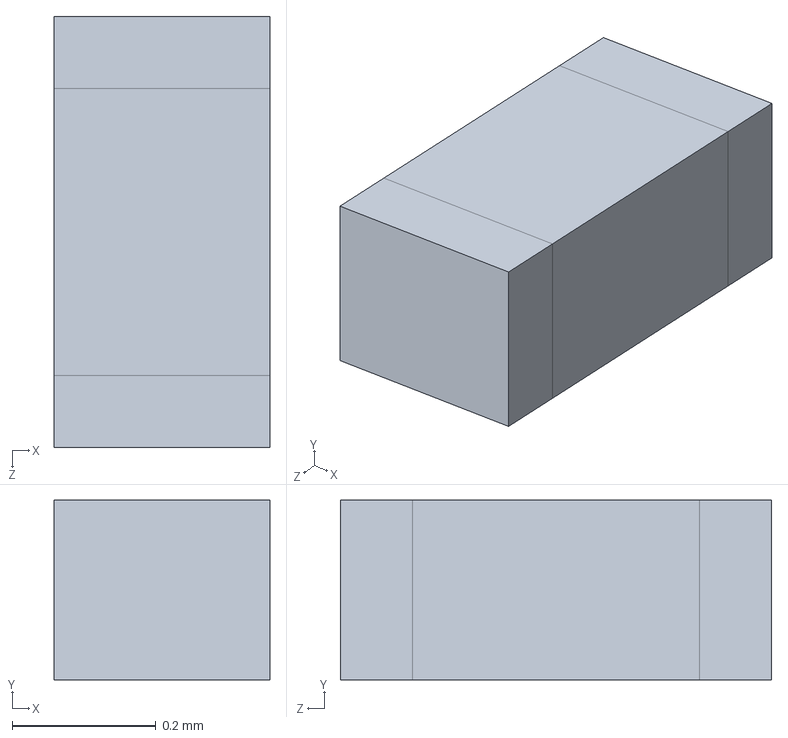
[picture p45: CAD file, 2023-09-07]
designs/hardware/bGeigieCast V1.6.0(StampS3)/bGeigieCast V1.6.0(StampS3)/Misc 3d files/m5stamp-c3-1.snapshot.3/SMD Resistor, Configurable, M5Stamp-C3.SLDPRT
0.3 x 0.25 x 0.6 mm
