Safecast/bGeigieCast/(list of files, cad)

Other CAD files:
designs/hardware/bGeigieCast V1.5.0 (ESP32-C3)/bGeigieCast V1.5.FCStd
designs/hardware/ESP32 nGeigieNano WiFi/xbee.step
designs/hardware/bGeigieCast V1.6.0(StampS3)/bGeigieCast V1.6.0(StampS3)/shapes3D/ESP-07v2_4wings.stl
designs/hardware/bGeigieCast V1.6.0(StampS3)/bGeigieCast V1.6.0(StampS3)/shapes3D/ESP-13-wroom-02_4wings.stl
designs/hardware/bGeigieCast V1.6.0(StampS3)/bGeigieCast V1.6.0(StampS3)/shapes3D/ESP-12.stl
designs/hardware/bGeigieCast V1.6.0(StampS3)/bGeigieCast V1.6.0(StampS3)/shapes3D/ESP-12E.stl
designs/hardware/bGeigieCast V1.6.0(StampS3)/bGeigieCast V1.6.0(StampS3)/shapes3D/ESP-12E_4wings.stl
designs/hardware/bGeigieCast V1.6.0(StampS3)/bGeigieCast V1.6.0(StampS3)/Misc 3d files/m5stamp-c3-1.snapshot.3/Female USB Type C Connector, M5Stamp-C3.SLDPRT
designs/hardware/bGeigieCast V1.6.0(StampS3)/bGeigieCast V1.6.0(StampS3)/Misc 3d files/m5stamp-c3-1.snapshot.3/M5Stamp-C3.x_b
designs/hardware/bGeigieCast V1.6.0(StampS3)/bGeigieCast V1.6.0(StampS3)/bGeigieCast V1.6.0(StampS3).FCStd
