Safecast/bGeigieCast/images/quick_start_guide/available_wifi_networks.png

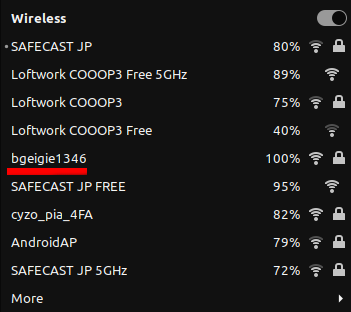
images/quick_start_guide/available_wifi_networks.png
