Safecast/bGeigieCast/images/quick_start_guide/bgeigienano_with_bgeigiecast.png

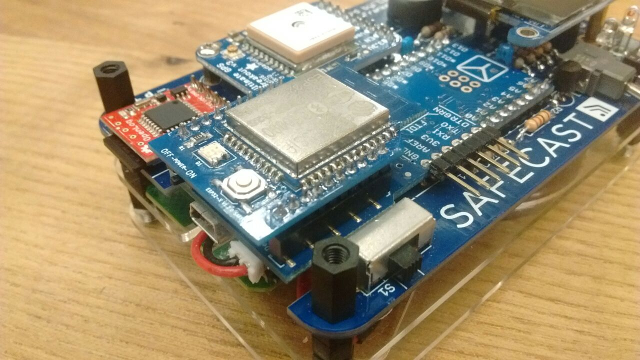
images/quick_start_guide/bgeigienano_with_bgeigiecast.png
