Safecast/bGeigieCast/images/quick_start_guide/connection_settings.png

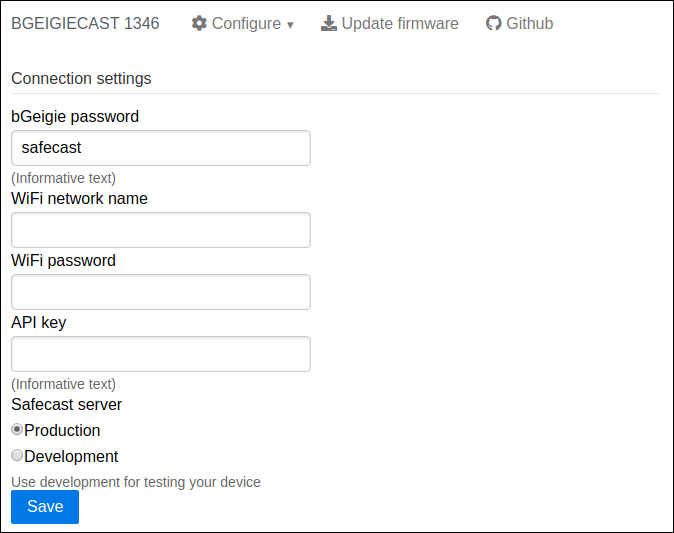
images/quick_start_guide/connection_settings.png
