Safecast/bGeigieCast/images/quick_start_guide/new/Screenshot from 2020-05-11 08-32-31.png

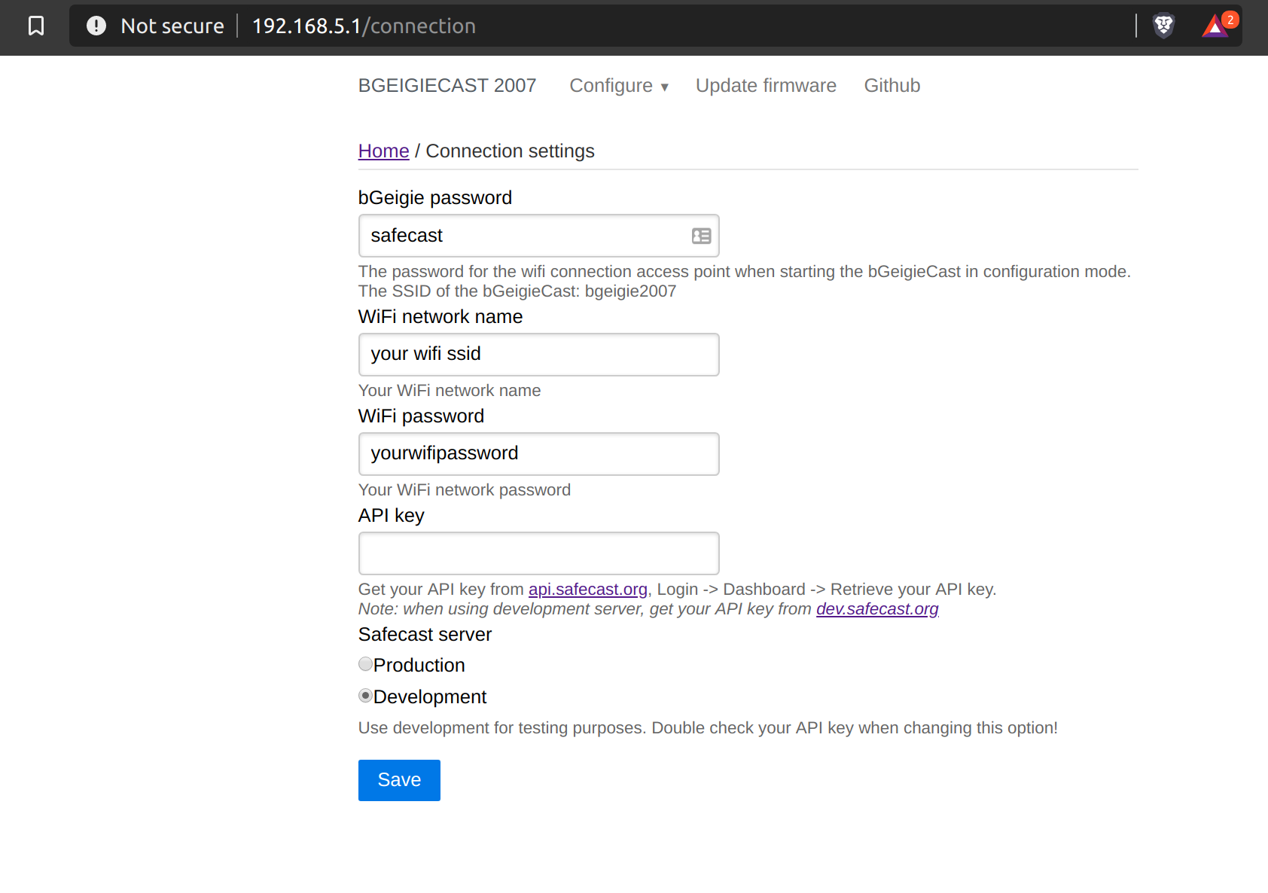
images/quick_start_guide/new/Screenshot from 2020-05-11 08-32-31.png
