Safecast/bGeigieCast/images/quick_start_guide/new/Screenshot from 2020-05-11 08-33-38.png

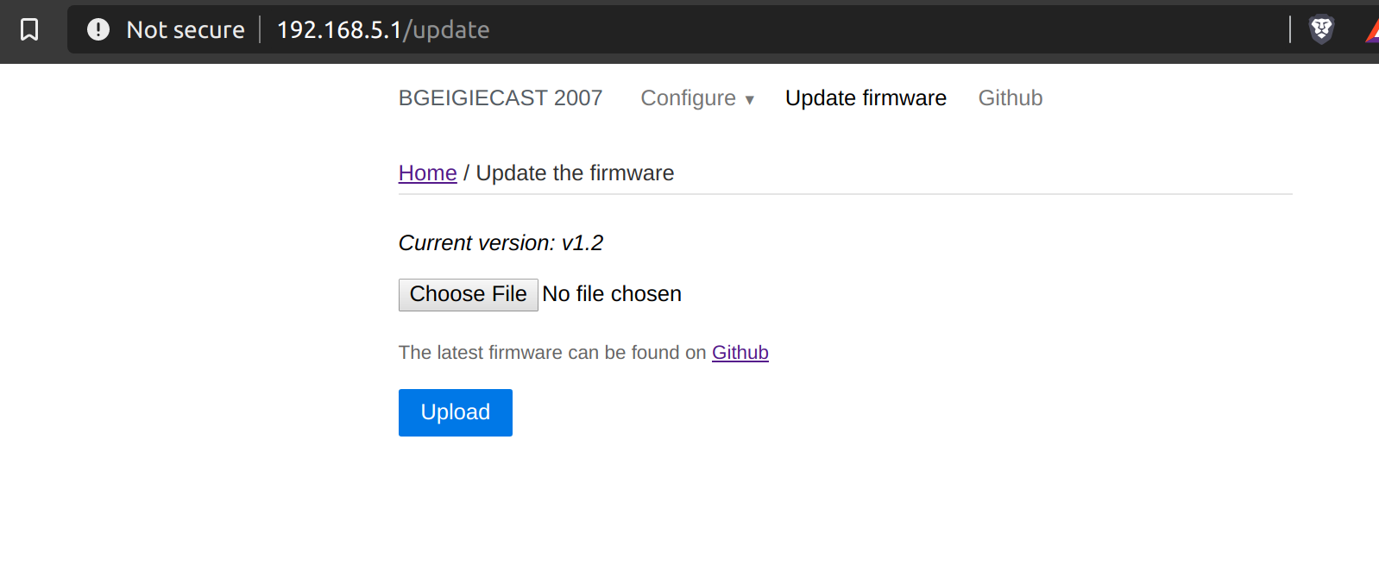
images/quick_start_guide/new/Screenshot from 2020-05-11 08-33-38.png
