Safecast/bGeigieCast/images/quick_start_guide/grafana_results.png

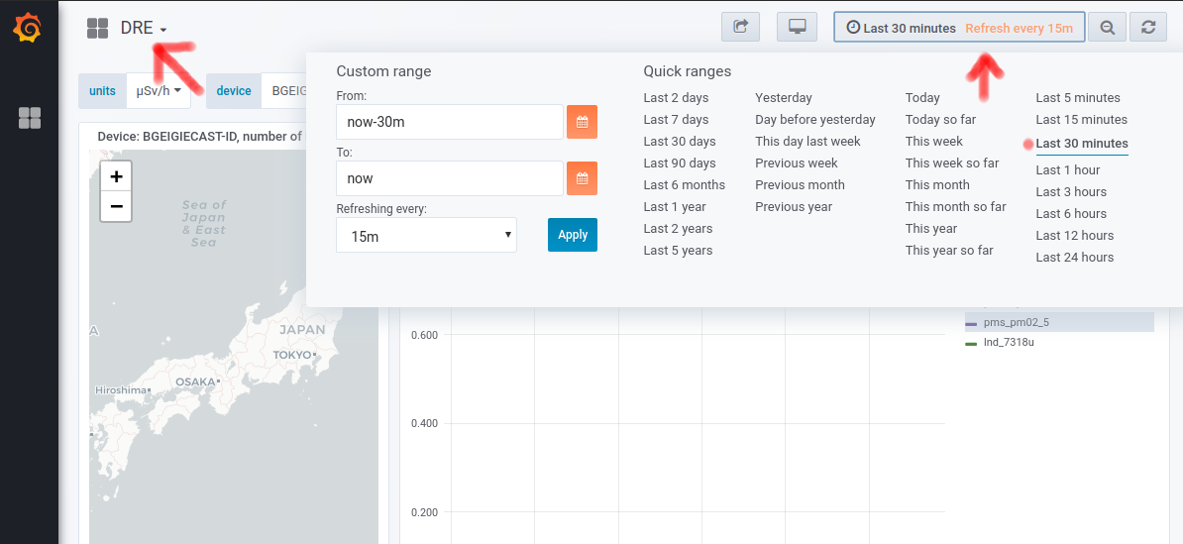
images/quick_start_guide/grafana_results.png
