Safecast/bGeigieCast/(threads)

Thread 16 (2019-03-12):

Dim the RGB led on the config option page of the web server. Or even better have a level setup for dimming and for off.

robouden, 2019-03-12:

Claypuppet, 2019-03-13:
@robouden Nice way to discuss other features like this. Lets try to put all our tasks in as issues so we can discuss (and keep track of) progress as well.

robouden, 2019-03-13:
Agreed :)

robouden, 2019-03-23:
Yes, what issues do you have open?

Closed 2019-03-28.

Thread 19 (2019-03-13):

Save the current state of the state machine and only switch back to other stages if the button is pressed. THis to prevent switching from fixed mode to mobile mode by any power changes.

robouden, 2019-03-13:
After running the firmware a few days, I notice that the fixed state needs to be reset many times. Even if I did not touch the button. Not sure why yet.

Maybe best if, when the button is pushed the state is saved in permanent storage. And every 1 minute or so, the permanent storage state is checked and updated accordingly.

robouden, 2019-03-20:
Done, works nice!!!

Closed 2019-03-20.

Thread 23 (2019-03-28):

Optimize power

robouden, 2019-03-28:
Let the ESP32 sleep without losing data that is being sent from the FIO. Maybe have the ULP reading the serial data and the two main cores sleeping most of the time.

Maybe even let the ULP do the counting and waking the main cores up after serial data is received?

Claypuppet, 2019-04-15:
Closing this, will be handled  #29 and others

Closed 2019-04-15.

Thread 24 (2019-04-11):

Add geofencing to the config webpage and test it.

robouden, 2019-04-11:
To have the wifi spot with fixed coordinates.
Maybe an option to switch this off by the button or by the wifi config page.

Claypuppet, 2019-04-15:
Will close this issue as we now have #32 #33 #34

Closed 2019-04-15.

Thread 26 (2019-04-15):

For board switch to the right to make space for the wireless connector. Have to be checked to see if the new boards have a bit more space under it.

robouden, 2019-04-15:

Claypuppet, 2019-04-15:
Maybe think of way to connect the wireless receiver as well (female headers with cable or use usb plug that fits)

Closed 2019-04-18.

Thread 27 (2019-04-15):

Cradle  for bGeigieCast Wireless charging

robouden, 2019-04-15:
Add 3D files
Add how-to print
Add how to make the wireless receiver
Add how to install the parts

Closed 2024-11-20.

Thread 32 (2019-04-15):

Add new fixed mode configurations

Claypuppet, 2019-04-15:
New configurations:
* My home home location (long / lat)
* Enable auto switch from mobile -> fixed when at home location

Add these configurations to the configuration component and the web server

Closed 2019-05-13.

Thread 33 (2019-04-15):

Auto switch from mobile to fixed mode (if enabled)

Claypuppet, 2019-04-15:
Check in mobile mode if:
* auto switch is enabled
* current location is near home location
* current location has been near home location for some time (5 min~)

Then check for wifi availability (thanks Rob) -> switch to fixed mode

--
Update this in state machine, new transition from mobile -> fixed

robouden, 2019-04-15:
Home location and also be autodetecting the wifi SSID and local GPS.

Claypuppet, 2019-04-15:
Right! Will add that as well

Closed 2024-11-20.

Thread 35 (2019-04-15):

Find a way to make configuring "my home location" easier for the user

Claypuppet, 2019-04-15:
maybe some button "use current location" or get the location of the first reading...

robouden, 2019-04-15:
Or get the location from the first 1 minute. Or manually enter the LAT and LON for the location.

Claypuppet, 2019-04-15:
Manually enter would be step one (in the config issue #32 )

Claypuppet, 2019-05-13:
Implemented this by saving the last know gps location (updating every time a new reading is parsed).

on config page the location is displayed with a "use this location" button to set the home location.

Closed 2019-05-13.

Thread 36 (2019-04-15):

Check for reading validity when taking averages (fixed mode)

Claypuppet, 2019-04-15:
Check for :

* sensor A/V, dont use the Void value in the average
* GPS A/V, dont use the value or location if its unavailable / out of range
etc..

Closed 2019-05-13.

Thread 40 (2019-04-30):

Create a board for ESP32 Xbee

robouden, 2019-04-30:
-2019-07-7 V1.4.0 (QR code changed and resistor removed shipped to KW)
-2019-05-09 send V1.2.0 to dirtypcbs.com
- 2019-04-30
     V1.2.0 of the board with no copyright, and 330uF cap. Needs also 1-ohm resistor in VCC line to the prevent reset of FIO.
- 2019-03-26 update
     first boards are made
-2019-04-03
     send final boards to Dirty PCB

Claypuppet, 2019-05-01:
Pieter also mentioned that the contact address should be info@safecast

robouden, 2019-05-01:
Yes, better.

Closed 2024-11-20.

Thread 43 (2019-05-02):

Delayed readings have wrong time in grafana

Claypuppet, 2019-05-02:
-- updated
Grafana displays graph using time when the measurement reached the api, not the actual time of measurement.

Claypuppet, 2019-05-09:
Reading the logs again, it looks like it _does_ send the correct time
```
// This is the current one, at time 02:39:27
{"captured_at":"2019-05-09T02:39:27Z","device_id":61346,"value":39,"unit":"cpm","longitude":139.6833,"latitude":35.6500}

// Oldest saved reading at time 02:39:12
{"captured_at":"2019-05-09T02:39:12Z","device_id":61346,"value":34,"unit":"cpm","longitude":139.6833,"latitude":35.6500}

// Second saved reading at time 02:39:17
{"captured_at":"2019-05-09T02:39:17Z","device_id":61346,"value":33,"unit":"cpm","longitude":139.6833,"latitude":35.6500}

// Third saved reading at time 02:39:22
{"captured_at":"2019-05-09T02:39:22Z","device_id":61346,"value":35,"unit":"cpm","longitude":139.6833,"latitude":35.6500}

```

robouden, 2019-05-09:
Good to hear that.

Claypuppet, 2019-05-09:
@robouden Looks like the issue is in grafana, Just did a little test
saved 3 readings (every 5 minutes) and then connect.

[In grafana it show this](https://grafana.safecast.cc/d/xDN0RWlmz/dre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)

This is the json data as shown in grafana:
```
{"_id":"rWK8mmoBuDPbqS2pf8i9","_type":"measurement","_index":"ingest-measurements-2019-05-09","device_urn":"geigiecast:61346","device_sn":"bGeigiecast #61346","device":61346,"when_captured":"2019-05-09T03:51:39Z","loc_lat":35.65,"loc_lon":139.6833,"loc_olc":"8Q7XMM2M+283","lnd_7318u":24,"dev_test":true,"service_uploaded":["2019-05-09T03:56:45.000Z"],"service_transport":"geigiecast:126.208.181.33","service_md5":"b983b071983634151f1744c3af6dbc91","service_handler":"i-051cab8ec0fe30bcd","@timestamp":"2019-05-09T03:56:45Z","ingest":{"location":{"lat":35.65,"lon":139.6833}}}
--
{"_id":"rGK8mmoBuDPbqS2pfchV","_type":"measurement","_index":"ingest-measurements-2019-05-09","device_urn":"geigiecast:61346","device_sn":"bGeigiecast #61346","device":61346,"when_captured":"2019-05-09T03:46:37Z","loc_lat":35.65,"loc_lon":139.6833,"loc_olc":"8Q7XMM2M+283","lnd_7318u":34,"dev_test":true,"service_uploaded":["2019-05-09T03:56:44.000Z"],"service_transport":"geigiecast:126.208.181.33","service_md5":"db7853cca0fbb3e85ee84a46c81a5e66","service_handler":"i-051a2a353509414f0","@timestamp":"2019-05-09T03:56:45Z","ingest":{"location":{"lat":35.65,"lon":139.6833}}}
{"_id":"qmK8mmoBuDPbqS2pd8ia","_type":"measurement","_index":"ingest-measurements-2019-05-09","device_urn":"geigiecast:61346","device_sn":"bGeigiecast #61346","device":61346,"when_captured":"2019-05-09T03:56:41Z","loc_lat":35.65,"loc_lon":139.6833,"loc_olc":"8Q7XMM2M+283","lnd_7318u":37,"dev_test":true,"service_uploaded":["2019-05-09T03:56:43.000Z"],"service_transport":"geigiecast:126.208.181.33","service_md5":"ed7e560743dfd1deaae4d15fd1ddfdaf","service_handler":"i-051cab8ec0fe30bcd","@timestamp":"2019-05-09T03:56:43Z","ingest":{"location":{"lat":35.65,"lon":139.6833}}}
{"_id":"q2K8mmoBuDPbqS2peshV","_type":"measurement","_index":"ingest-measurements-2019-05-09","device_urn":"geigiecast:61346","device_sn":"bGeigiecast #61346","device":61346,"when_captured":"2019-05-09T03:41:36Z","loc_lat":35.65,"loc_lon":139.6833,"loc_olc":"8Q7XMM2M+283","lnd_7318u":37,"dev_test":true,"service_uploaded":["2019-05-09T03:56:44.000Z"],"service_transport":"geigiecast:126.208.181.33","service_md5":"58dae1dd3dc547c85b1fb252b046400b","service_handler":"i-0c65ac97805549e0d","@timestamp":"2019-05-09T03:56:44Z","ingest":{"location":{"lat":35.65,"lon":139.6833}}}
```

The when_captured is the moment it got captured and @timestamp is the moment it got uploaded to the API. Grafana builds the graph based on the @timestamp

Claypuppet, 2019-05-09:
@robouden I'll leave this to you for now

robouden, 2019-05-09:
ok

robouden, 2019-05-09:
By changing:

Closed 2024-11-20.

Thread 54 (2019-07-06):

finish manual

robouden, 2019-07-06:
Some parts are not finished.

robouden, 2019-07-31:
I will add my notes a bit later.. In the wrong format now.

Claypuppet, 2019-08-01:
So as for your notes:
- Prepare for long time sensor: I wanted to link to different page here with dock & wireless charging instructions: how to print the dock, but more importantly, how to connect the wireless receiver. Lets discuss this first before we make the guide.
- Troubleshooting: Yes still need to think of ways to troubleshoot
- Dev environment: For Arduino IDE i will do the steps myself on my desktop (clean environment) and write those down, maybe you can write something for VSCodium?
- Designs: That image is "outdated" as the sequence is now in the state machine. I could create a simpler diagram with loop just for the whole data flow
- Design choices, not sure what to do with this one, quite outdated..
- Things needed for fixed sensor: I think this will fit well in the user manual (required software / hardware), we can link from other pages to there

Can we make some separate issues for these?

robouden, 2019-08-01:
Yes, a good idea to make separate issues out of them.

Closed 2024-11-20.

Thread 56 (2020-02-09):

Create  Video for how to setup/how to use

robouden, 2020-02-09:
**bGeigieCast Videos**

**Quick start guide. How to use**
- Startup
- Config
- Bluetooth
- Wifi
- Fixed mode
- Connected
- Grafana

**Wireless charger video.**
- 3D models
- How Printing
- Wireless charger in cradle
- Wireless receiver in BgeigieNano

**Misc:**
Check plugin for charging in bGeigieNano more simple direct to FTDI?
Manual for building Github bGeigieCast Cradle.

Thread 58 (2021-03-06):

Send the data in batches

robouden, 2021-03-06:
It would be a better way to get all the data from the bGeigeiNano in batches to the api and not average (as now) calculated over 30 seconds or 5 minutes.

matschaffer, 2021-03-06:
Maybe worth mentioning that this came up due to finding some odd gps points from @jamoross ’s geigiecast.

I can post a kibana link later but it looks like the device averaged some valid and invalid gps coordinates and sent us 0.003,0.009 as the location.

It’d be good if we can only send the same points that show up in the log, perhaps filtered to only points with reasonable gps confidence.

matschaffer, 2021-03-06:
Here's one of the points in question http://kibana.safecast.cc/app/kibana?id=UFd7vXcBj2uUTIA-1wb7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(refreshInterval:(pause:!t,value:0),time:(from:'2021-02-12T12:28:03.937Z',to:'2021-02-24T05:23:17.620Z')), see https://api.safecast.org/en-US/bgeigie_imports/51022 for the SD log.

```json
{
    "device_urn": "geigiecast:62025",
    "device_class": "geigiecast",
    "device": 62025,
    "when_captured": "2021-02-20T03:28:47Z",
    "loc_lat": 0.00253,
    "loc_lon": 0.00944,
    "loc_olc": "6FG22235+2Q8",
    "lnd_7318u": 104,
    "dev_test": true,
    "service_uploaded": "2021-02-20T03:29:05Z",
    "service_transport": "geigiecast:172.58.27.225",
    "service_handler": "i-051cab8ec0fe30bcd",
    "@timestamp": "2021-02-20T03:28:47Z",
    "ingest": {
      "location": {
        "lat": 0.00253,
        "lon": 0.00944
      }
    }
```

matschaffer, 2021-03-06:
Which would be here, way of the actual drive path.

https://www.google.com/maps/place/0%C2%B000'09.1%22N+0%C2%B000'34.0%22E/@0.0025354,-4.4729817,6z/data=!4m5!3m4!1s0x0:0x0!8m2!3d0.00253!4d0.00944

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

robouden, 2021-03-06:
That is probally a rounding error for  "NO GPS" (meaning 0,0) and a valid location.

matschaffer, 2021-03-06:
```
$BNRDD,2025,2021-02-20T03:28:17Z,106,16,10479,A,3742.1517,N,14044.9053,E,468.20,A,7,124*77
$BNRDD,2025,2021-02-20T03:28:22Z,107,8,10487,A,3742.1082,N,14044.9270,E,467.50,A,7,124*4C
$BNRDD,2025,2021-02-20T03:28:27Z,104,4,10491,A,3742.0719,N,14044.9486,E,465.50,A,7,124*48
$BNRDD,2025,2021-02-20T03:28:32Z,101,10,10501,A,3742.0514,N,14044.9806,E,460.50,A,8,107*74
$BNRDD,2025,2021-02-20T03:28:37Z,106,9,10510,A,3742.0405,N,14045.0310,E,457.40,A,8,114*4C
$BNRDD,2025,2021-02-20T03:28:42Z,104,7,10517,A,3742.0237,N,14045.0877,E,454.70,A,9,97*73
$BNRDD,2025,2021-02-20T03:28:47Z,105,5,10522,A,3742.0035,N,14045.1421,E,452.50,A,9,107*41
```

It's interesting looking at the log though. I don't see any invalid gps markers (should be "V") according to https://github.com/Safecast/bGeigieNanoKit/wiki/Operations-Manual#data-log

Any idea how the 0 might have reached the geigiecast for averaging?

matschaffer, 2021-03-06:
There are some `V` in the log, but not quite around that point and not with 0 GPS either

```
$BNRDD,2025,2021-02-20T02:22:24Z,47,4,6686,A,3744.8688,N,14042.7826,E,467.80,V,9,90*64
$BNRDD,2025,2021-02-20T02:22:49Z,50,6,6706,A,3744.8688,N,14042.7827,E,467.80,V,9,90*63
$BNRDD,2025,2021-02-20T02:39:39Z,89,10,7532,A,3744.3502,N,14043.6016,E,407.10,V,6,131*63
$BNRDD,2025,2021-02-20T02:39:54Z,80,7,7547,A,3744.2812,N,14043.6827,E,399.00,V,7,115*54
$BNRDD,2025,2021-02-20T02:39:59Z,77,3,7550,A,3744.2711,N,14043.6810,E,396.00,V,7,129*5B
$BNRDD,2025,2021-02-20T02:40:04Z,86,12,7562,A,3744.2520,N,14043.6632,E,395.30,V,7,129*6C
$BNRDD,2025,2021-02-20T02:40:09Z,84,4,7566,A,3744.2353,N,14043.6481,E,394.30,V,7,129*59
```

matschaffer, 2021-03-06:
If it's possible it'd be great to have the geigiecast post the same data we'd find in a log. If every 5s will drain too much battery, then perhaps we could send the data in batches.

matschaffer, 2021-03-06:
For now I think we can probably just ignore stuff stuff with lat/lon in the 0-0.01 range when making graphs and maps.

matschaffer, 2021-03-06:
Hrm... also curious is that we seemed to get basically no data from the geigiecast around that time into ingest:

http://kibana.safecast.cc/app/kibana#/discover?_g=(filters:!(),refreshInterval:(pause:!t,value:0),time:(from:'2021-02-20T01:12:16.566Z',to:'2021-02-20T05:10:50.542Z'))&_a=(columns:!(loc_lat,loc_lon,lnd_7318u),filters:!(('$state':(store:appState),meta:(alias:!n,disabled:!f,index:'ingest-measurements-*',key:device_urn,negate:!f,params:(query:'geigiecast:62025'),type:phrase),query:(match:(device_urn:(query:'geigiecast:62025',type:phrase)))),('$state':(store:appState),meta:(alias:!n,disabled:!t,index:'ingest-measurements-*',key:loc_lat,negate:!f,params:(gte:0,lt:0.01),type:range),range:(loc_lat:(gte:0,lt:0.01)))),index:'ingest-measurements-*',interval:auto,query:(language:kuery,query:'loc_lat%3E0%20and%20loc_lat%3C0.01'),sort:!(!(service_uploaded,desc)))

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

matschaffer, 2021-03-06:
I must have just had something weird going on in my browser for that last screenshot. Data is there, here's the section with the weird point that reached ingest.

https://5bc3d4f7330a4459881197a85659caf5.us-west-2.aws.found.io:9243/goto/58d9e28960c21350967606230935dd69
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

matschaffer, 2021-03-06:
Here's a CSV incase it's helpful (zipped for github)
[[Mat] weirdo point from Joe's geigiecast.csv.zip](https://github.com/Safecast/bGeigieCast/files/6095044/Mat.weirdo.point.from.Joe.s.geigiecast.csv.zip)

robouden, 2021-03-06:
The bGeigieCast was not designed to be a life streaming thing. It was made to be equivalent to the pointcast. That is why the 5 minutes come in. The 30 seconds were made for testing only, but I used it as a kind of live streaming.

matschaffer, 2021-03-06:
Yeah, that's understandable. I think it still works pretty well for both purposes and filtering after the fact isn't hard.

Closed 2024-11-20.

Thread 59 (2021-07-17):

Missing static coordinate mode for fixed location sensing where GPS reception/accuracy is poor

justin270f, 2021-07-17:
When the bGeigieCast is used as a fixed location sensor in cities with tall buildings, it is usually placed on the side of building structure where half of the sky is blocked by the building itself (except in the unlikely case where you have long term access to the rooftop). This means that it can only see a subset of GPS satellites, not to mention the satellites are constantly moving in and out of view causing extremely poor accuracy and sometimes completely looses GPS lock.
In an actual test at a height of 95m from the side of a 110m tall building, I got a GPS accuracy that constantly jumped around 300m to 2.5km and lost GPS lock for roughly 40% of the time. This causes the original mode with a fixed Geofencing coordinate completely useless due to the 100m range limit, and even the basic mode using live GPS coordinates is no good because valid sensor data would be dropped 40% of the time without GPS lock, and even when GPS location is available, it would fail to represent the actual fixed location when the detected location jumps around so much.

What we need is a simple mode that lets the user select a static coordinate for a fixed location, bypassing the GPS checks and  coordinates to ensure a 100% reliable and consistent fixed location sensing.

Closed 2024-11-20.

Thread 60 (2024-07-16):

Device Settings wont get saved

BRSMaulwurf, 2024-07-16:
Im currently running firmware V1.5
and the device setting "Wifi Server" wont get saved after power lost.
All the other settings like Wifi-Password, API-Key, etc. remains after shut down the bGeigie.

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

robouden, 2024-07-16:
BRS,

You want the page to be able enabled/accessible over your wifi network?

Regards
Rob

BRSMaulwurf, 2024-07-17:
Yes. I want to put my bGeigie in a hard case on my balcony as stationary sensor. Therefore it would be nice to be able to access the cast plattform via wifi for firmware updates and settings. I dont want to demount the case, and open it, to activate the configuration mode manually.
If the wifi network platform is enabled the whole time even after a power lost, this would be perfect.

Maybe later it would be possible to show the latest CPM readings or other statistics on this web platform too 😲

Best regards
Philipp

robouden, 2024-07-17:
Phillip,

Thanks for the explanation.
I hope Jelle can make a fix for the stickiness of status of the Wi-Fi server settings for it soon.

Regards
Rob  Oudendijk

BRSMaulwurf, 2024-11-22:
I´ve seen there is an update on this request.
Is the "firmeware-1.5.bin" in [bGeigieCast/firmware/](https://github.com/Safecast/bGeigieCast/tree/updates-july-2023_M5stampS3_1-6-2_boards/firmware) the new update?
Shouldn´t this be version 1.6? because 1.5 is already existing in the other folders.

Best regards and thanks for the update
Philipp

robouden, 2024-11-22:
Philip,

V1.5 is the latest with the fix mentioned.

Hugs and peace,
rob

On Sat, Nov 23, 2024 at 5:45 AM BRSMaulwurf ***@***.***>
wrote:

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

Closed 2024-11-20.

Thread 61 (2024-11-19):

bGeigieCast adapter kicad/gerber files for stamp-S3 version1.6.2 is missing

3uky, 2024-11-19:
Latest uploaded version for cast adapter is 1.6.1 but newer version [1.6.2](https://raw.githubusercontent.com/Safecast/bGeigieCast/development/images/wiki/S4900033.jpg) is missing from git repository. I believe this is latest version. Could you please upload those files.

robouden, 2024-11-19:
3uky,

Just updated the files. The files were not so good organized. Maybe cleaner now. V1.6.2 seems correct now.
I will also export the Gerber file (in case you do not run the nightly build of KiCad and can not open the files).

Regards
Rob Oudendijk

3uky, 2024-11-19:
Thank you Rob. Based on your answer I have realized that 1.6.2 version was in updates-july-2023_M5stampS3 branch so for my goal it's enough. I have access to nightly builds so working with kicad files is no issue.

I have look on changes in updates-july-2023_M5stampS3_1-6-2_boards branch and merge with development branch result in corruption of several gerber/kicad files so it would be better reset branch and merge again it if it's needed. For future users as me it would be great to have latest kicad, gerber, code in some main branch (development).

robouden, 2024-11-20:
Hynek,

Thanks for mention it.
I resented the branch and merge it into development branch.

Regards
Rob Oudendijk

On Wed, Nov 20, 2024 at 4:35 AM Hynek Buček ***@***.***>
wrote:

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

Closed 2024-11-19.
