Safecast/bGeigieCast/(list of files, drawings)

Other design files:
designs/hardware/bGeigieCast V1.6.0(StampS3)/bGeigieCast V1.6.0(StampS3)/bGeigieCast V1.6.0(StampS3).dsn
