Safecast/bGeigieCast/designs/hardware/bGeigieCast V1.6.0(StampS3)/bGeigieCast V1.6.0(StampS3)/bGeigieCast V1.6.0(StampS3).kicad_pcb

## KiCad design designs/hardware/bGeigieCast V1.6.0(StampS3)/bGeigieCast V1.6.0(StampS3)/bGeigieCast V1.6.0(StampS3).kicad_pcb (2023-09-07)

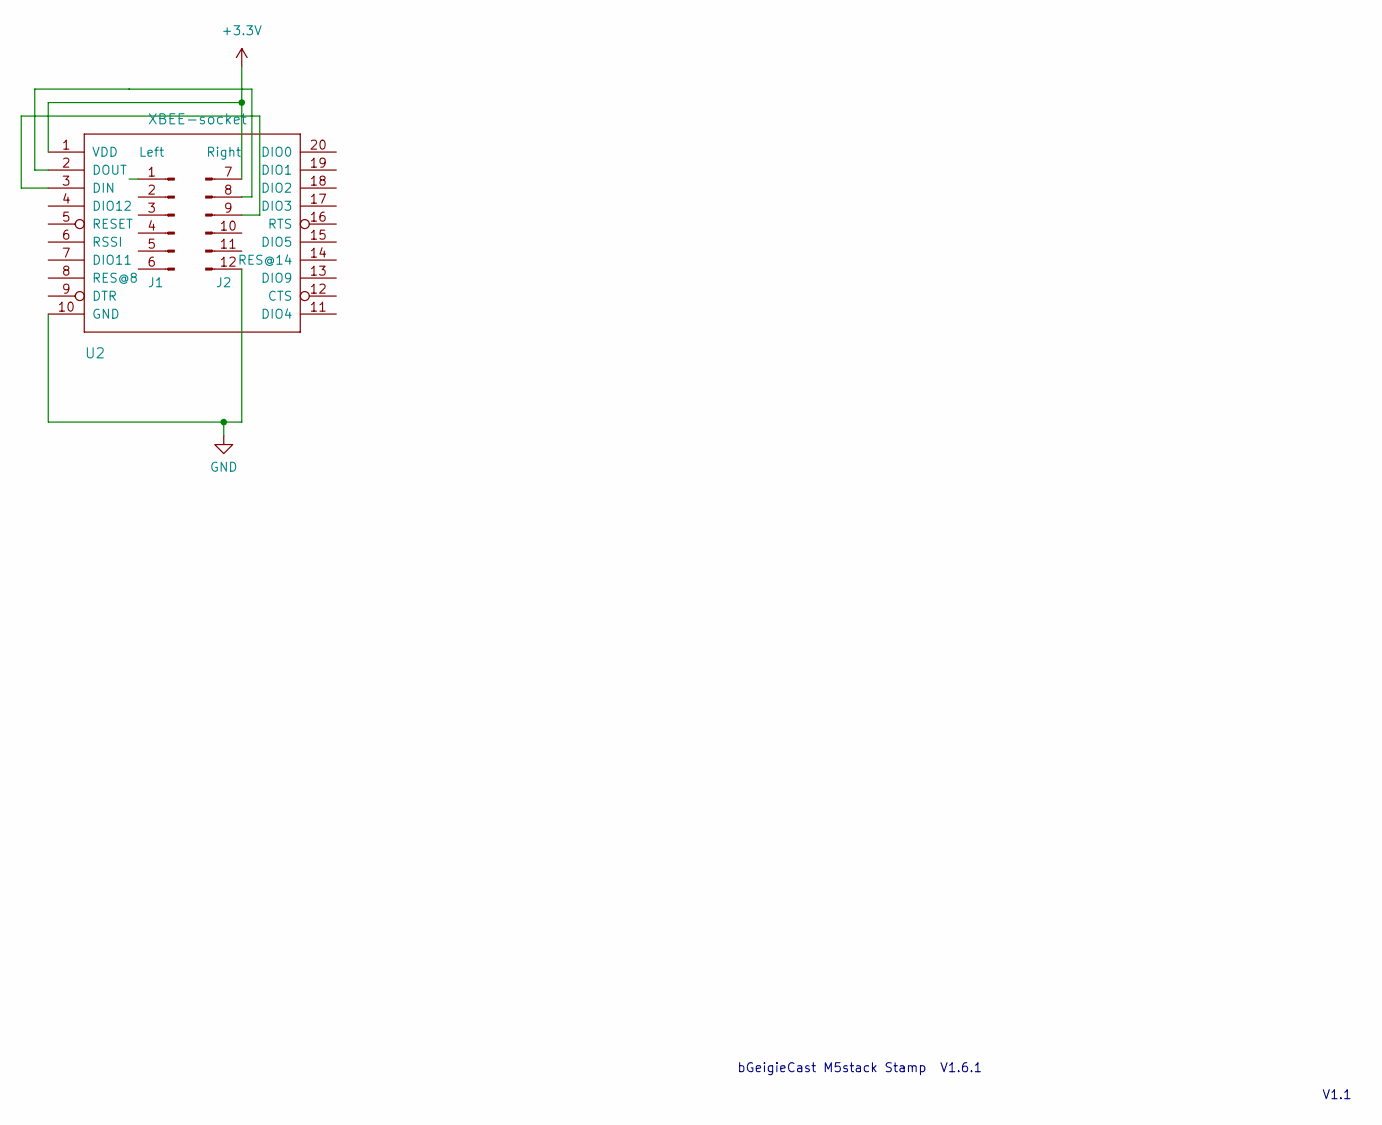
[picture p57: schematic bGeigieCast V1.6.0(StampS3).kicad_sch]

Parts:
J1: Left; PinHeader_1x09_P2.54mm_Vertical
J2: Right; PinHeader_1x06_P2.54mm_Vertical
U2: XBEE-socket; XBEE-20_THT

Connections:
+3.3V: J2.7, U2.1 (VDD)
GND: J2.12, U2.10 (GND)
unnamed: J2.8, U2.2 (DOUT)
unnamed: J2.9, U2.3 (DIN)

Notes on the sheet:
V1.1
bGeigieCast M5stack Stamp V1.6.1

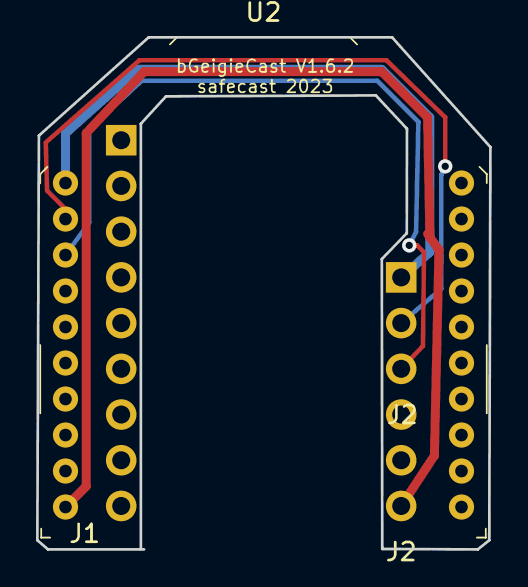
[picture p58: board bGeigieCast V1.6.0(StampS3).kicad_pcb from above]

Board: 2 copper layers, 25.2 x 28.4 mm, 3 parts (0 on the bottom side), 4 nets.
