Safecast/bGeigieCast/designs/hardware/ESP32 nGeigieNano WiFi/xbee.kicad_pcb

## KiCad design designs/hardware/ESP32 nGeigieNano WiFi/xbee.kicad_pcb (2023-07-28)

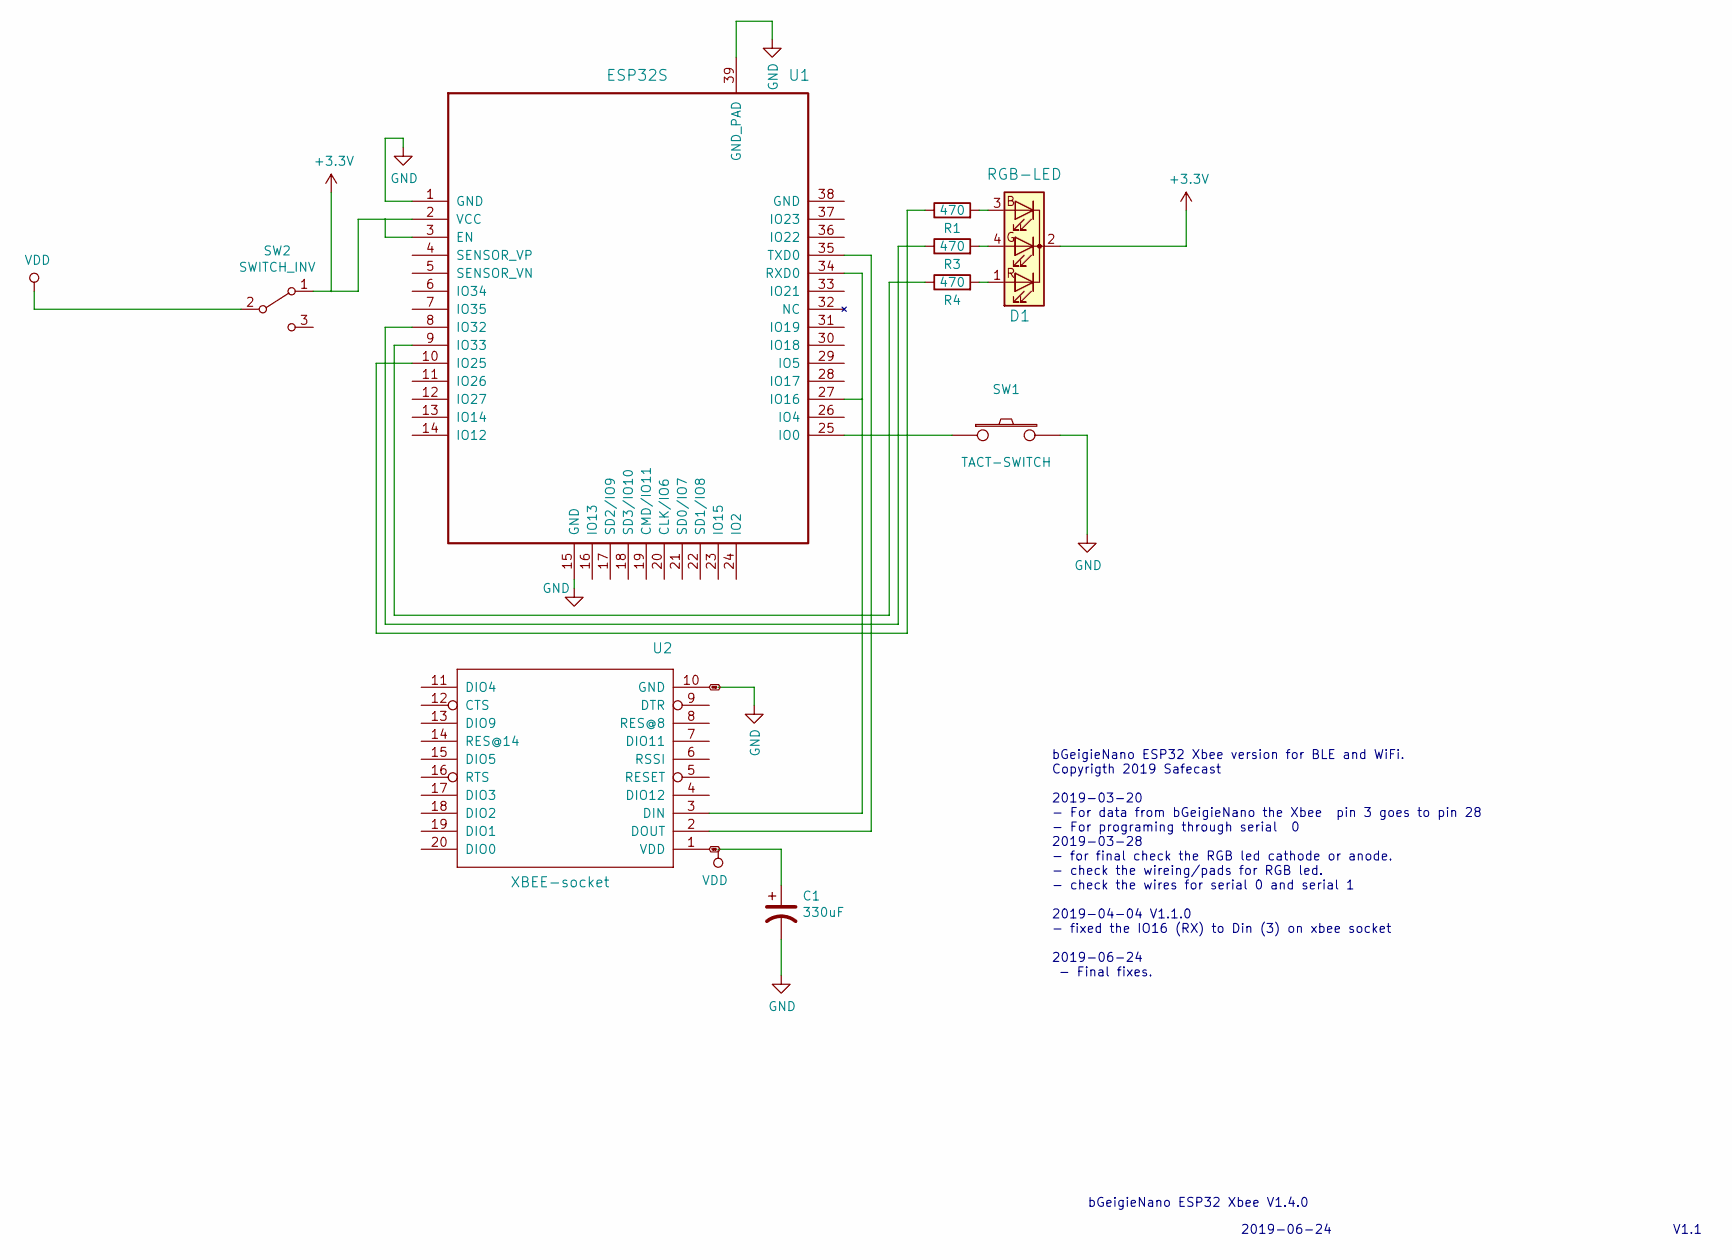
[picture p59: schematic xbee.kicad_sch]

Parts:
C1: 330uF; CP_EIA-6032-15_Kemet-U_Pad2.25x2.35mm_HandSolder
D1: RGB-LED; DJS-BRGBC-TR8
R1, R3, R4: 470; R_0805_HandSoldering
SW1: TACT-SWITCH; SW_SPST_TL3342
SW2: SWITCH_INV; SW_SPDT_PCM12
U1: ESP32S; ESP-32S
U2: XBEE-socket; XBEE-20_THT

Connections:
+3V3: D1.2 (K), SW2.1 (A), U1.2 (VCC), U1.3 (EN)
GND: C1.2, SW1.2, U1.1 (GND), U1.15 (GND), U1.39 (GND_PAD), U2.10 (GND)
unnamed: D1.3 (BA), R1.2
unnamed: D1.4 (GA), R3.2
unnamed: D1.1 (RA), R4.2
unnamed: SW1.1, U1.25 (IO0)
unnamed: U1.27 (IO16), U1.34 (RXD0), U2.3 (DIN)
unnamed: R1.1, U1.10 (IO25)
unnamed: R3.1, U1.8 (IO32)
unnamed: R4.1, U1.9 (IO33)
unnamed: U1.35 (TXD0), U2.2 (DOUT)
VDD: C1.1, SW2.2 (B), U2.1 (VDD)

Notes on the sheet:
bGeigieNano ESP32 Xbee version for BLE and WiFi. Copyrigth 2019 Safecast 2019-03-20 - For data from bGeigieNano the Xbee pin 3 goes to pin 28 - For programing through serial 0 2019-03-28 - for final check the RGB led cathode or anode. - check the wireing/pads for RGB led. - check the wires for seri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
bGeigieNano ESP32 Xbee V1.4.0
2019-06-24
V1.1

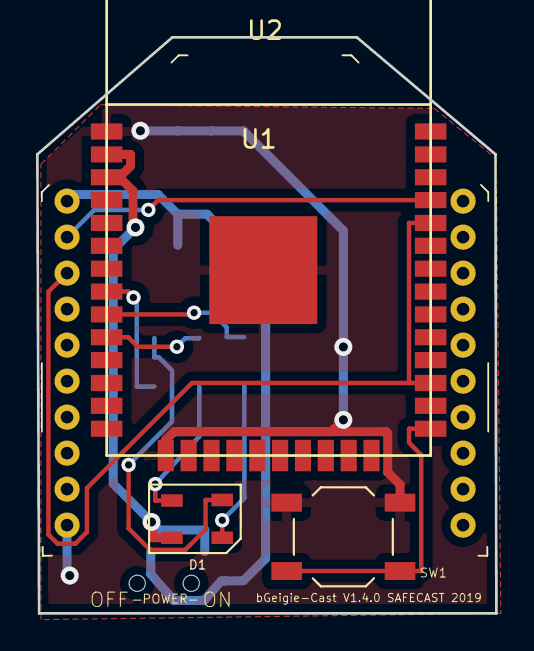
[picture p60: board xbee.kicad_pcb from above]

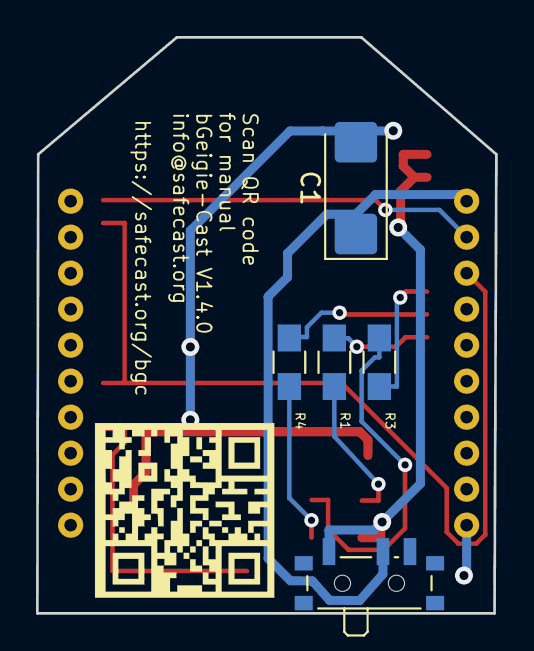
[picture p61: board xbee.kicad_pcb from below]

Board: 2 copper layers, 25.5 x 32.0 mm, 9 parts (5 on the bottom side), 12 nets.
