Safecast/bGeigieCast/designs/hardware/bGeigieCast V1.5.0 (ESP32-C3)/bGeigieCast V1.5.kicad_pcb

## KiCad design designs/hardware/bGeigieCast V1.5.0 (ESP32-C3)/bGeigieCast V1.5.kicad_pcb (2021-06-23)

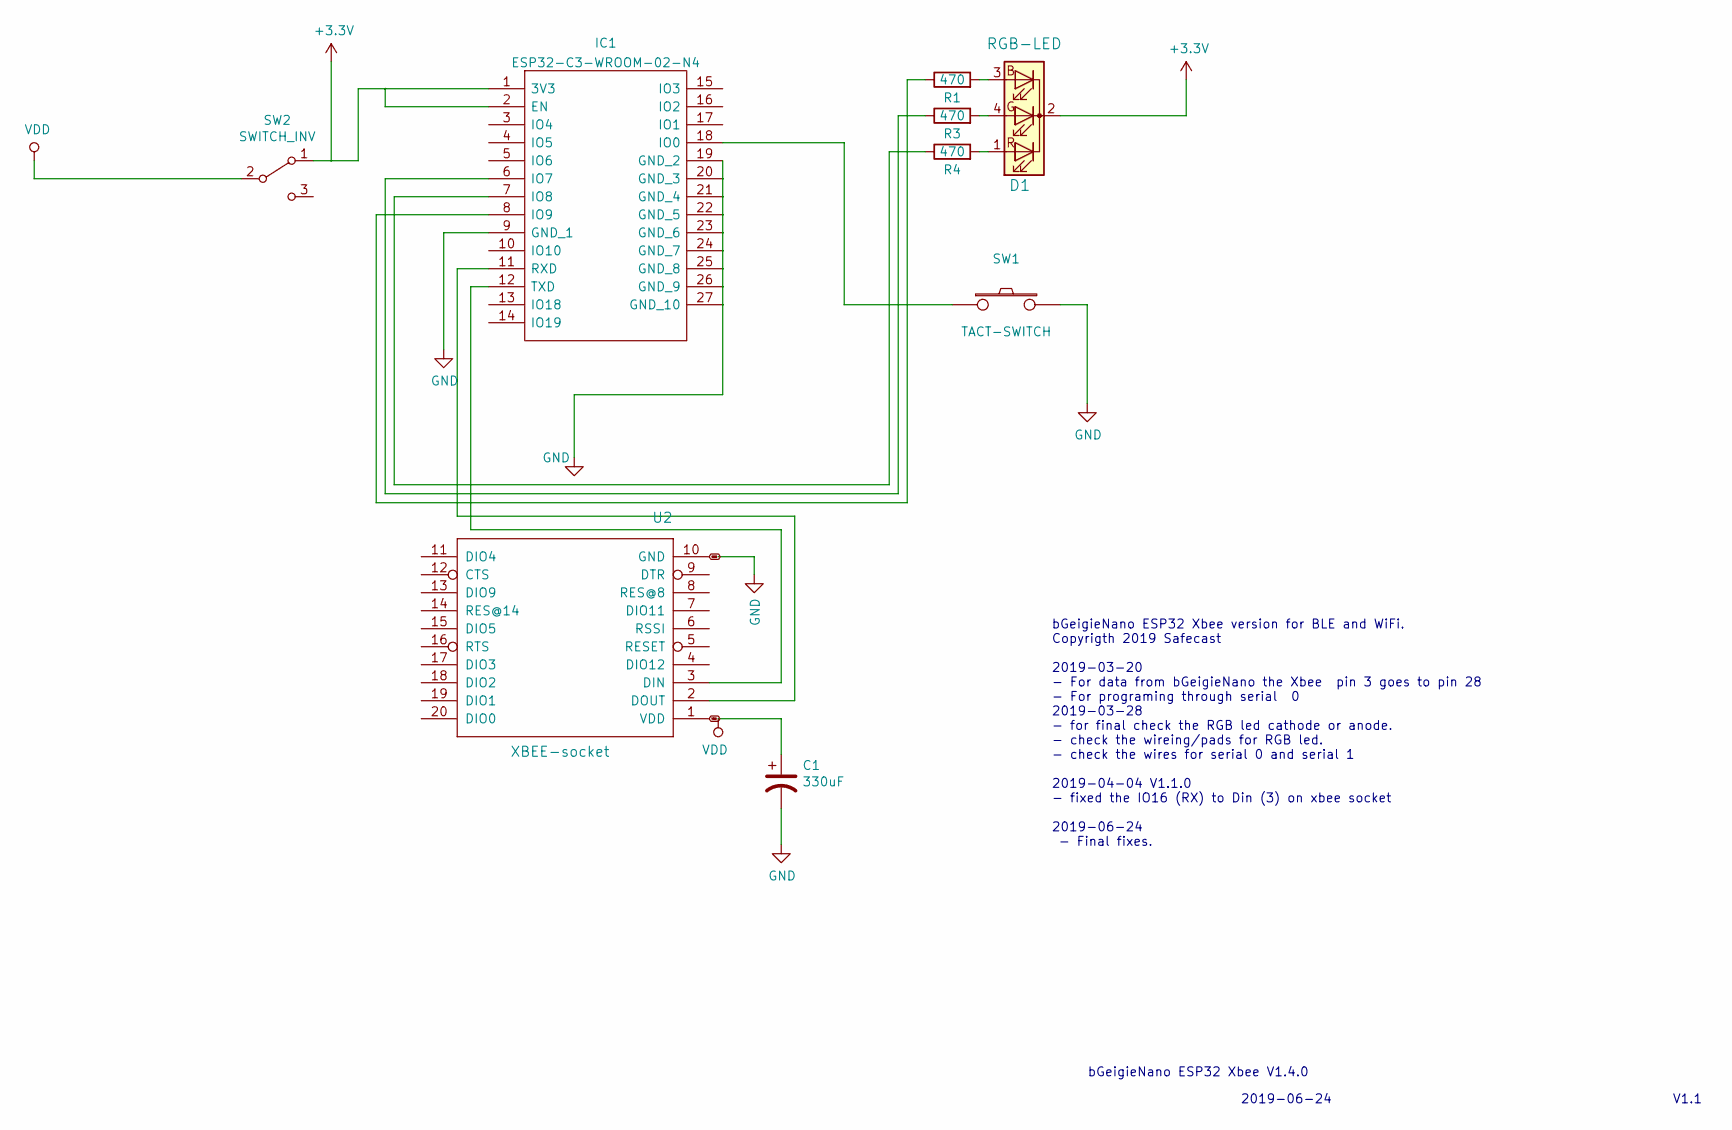
[picture p62: schematic bGeigieCast V1.5.kicad_sch]

Parts:
C1: 330uF; CP_EIA-6032-15_Kemet-U_Pad2.25x2.35mm_HandSolder
D1: RGB-LED; DJS-BRGBC-TR8
IC1: ESP32-C3-WROOM-02-N4; ESP32C3WROOM02N4; Manufacturer_Part_Number ESP32-C3-WROOM-02-N4; Mouser Part Number 356-ESP32C3WROOM02N4
R1, R3, R4: 470; R_0805_HandSoldering
SW1: TACT-SWITCH; SW_SPST_TL3342
SW2: SWITCH_INV; SW_SPDT_PCM12
U2: XBEE-socket; XBEE-20_THT

Connections:
+3V3: D1.2 (K), IC1.1 (3V3), IC1.2 (EN), SW2.1 (A)
GND: C1.2, IC1.9 (GND_1), IC1.19 (GND_2), IC1.20 (GND_3), IC1.21 (GND_4), IC1.22 (GND_5), IC1.23 (GND_6), IC1.24 (GND_7), IC1.25 (GND_8), IC1.26 (GND_9), IC1.27 (GND_10), SW1.2, U2.10 (GND)
unnamed: D1.1 (RA), R4.2
unnamed: D1.3 (BA), R1.2
unnamed: D1.4 (GA), R3.2
unnamed: IC1.8 (IO9), R1.1
unnamed: IC1.6 (IO7), R3.1
unnamed: IC1.7 (IO8), R4.1
unnamed: IC1.18 (IO0), SW1.1
unnamed: IC1.11 (RXD), U2.2 (DOUT)
unnamed: IC1.12 (TXD), U2.3 (DIN)
VDD: C1.1, SW2.2 (B), U2.1 (VDD)

Notes on the sheet:
bGeigieNano ESP32 Xbee version for BLE and WiFi. Copyrigth 2019 Safecast 2019-03-20 - For data from bGeigieNano the Xbee pin 3 goes to pin 28 - For programing through serial 0 2019-03-28 - for final check the RGB led cathode or anode. - check the wireing/pads for RGB led. - check the wires for seri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
bGeigieNano ESP32 Xbee V1.4.0
2019-06-24
V1.1

Board: 2 copper layers, 9 parts (5 on the bottom side), 12 nets, no tracks yet.
