Safecast/bGeigieCast/designs/hardware/bGeigieCast V1.6.0(StampS3)/bGeigieCast V1.6.0(StampS3)/bGeigieCast V1.6.0(StampS3).kicad_sch

## KiCad design designs/hardware/bGeigieCast V1.6.0(StampS3)/bGeigieCast V1.6.0(StampS3)/bGeigieCast V1.6.0(StampS3).kicad_sch (2023-09-07, an earlier design)

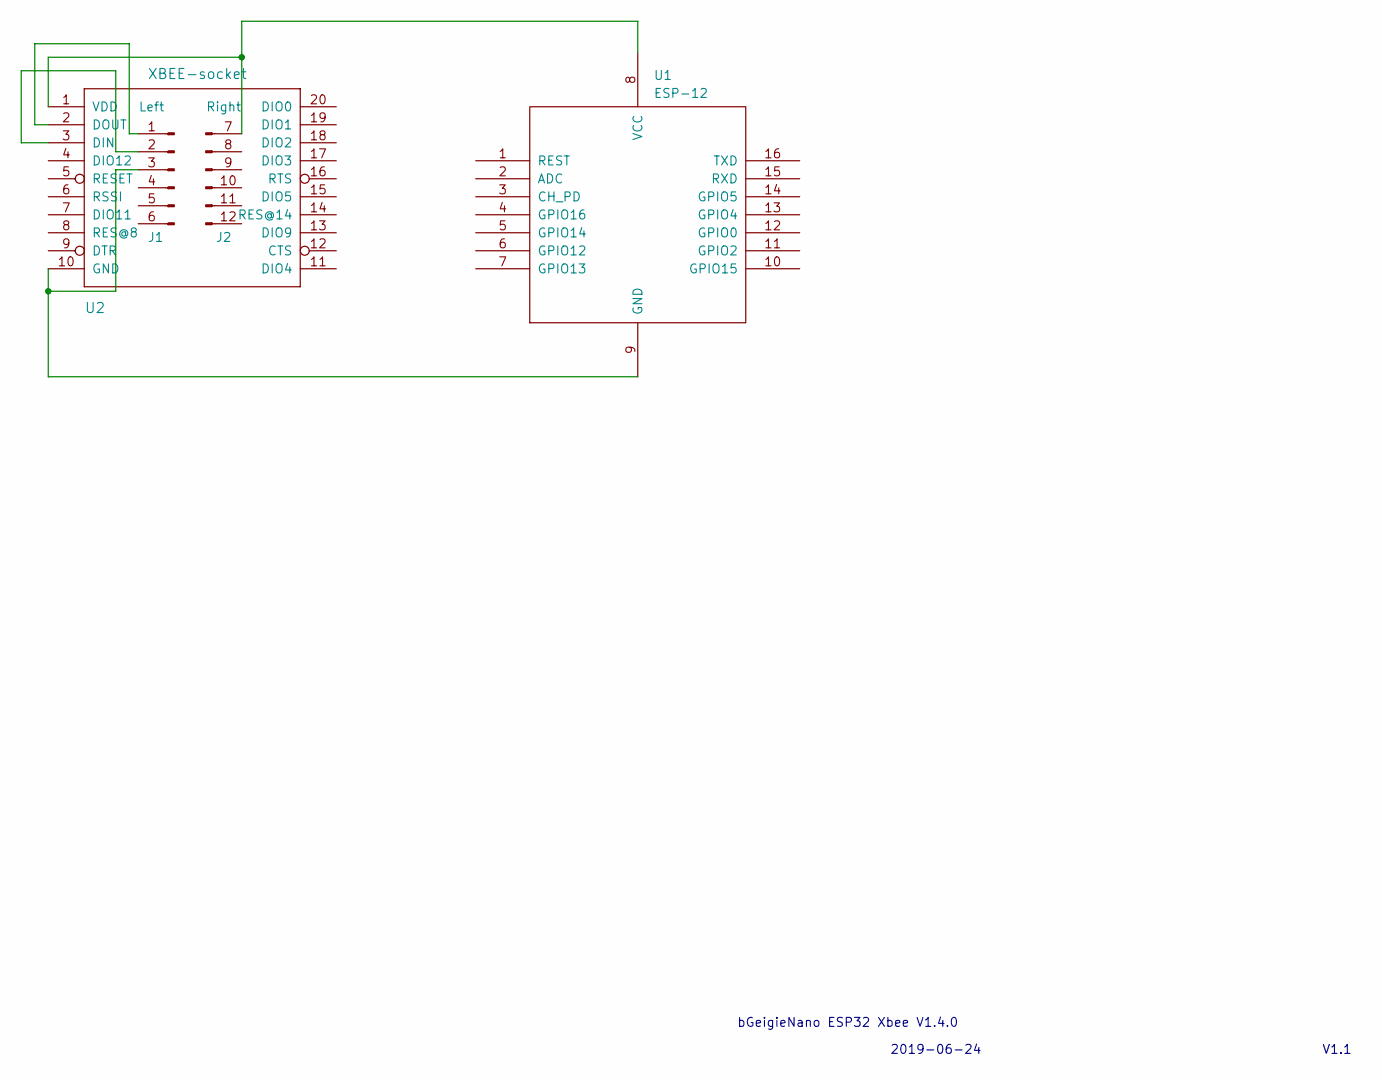
[picture p63: schematic bGeigieCast V1.6.0(StampS3).kicad_sch]

Parts:
J1: Left; PinHeader_1x06_P2.54mm_Vertical
J2: Right; PinHeader_1x06_P2.54mm_Vertical
U1: ESP-12
U2: XBEE-socket; XBEE-20_THT

Connections:
unnamed: J1.1 (Pin_6), U2.2 (DOUT)
unnamed: J1.2 (Pin_5), U2.3 (DIN)
unnamed: J1.3 (Pin_4), U1.9 (GND), U2.10 (GND)
unnamed: J2.7, U1.8 (VCC), U2.1 (VDD)

Notes on the sheet:
V1.1
bGeigieNano ESP32 Xbee V1.4.0
2019-06-24
