Safecast/bGeigieCast/bgeigiecast/sm_c_concrete_states.cpp

#include <Aggregator.hpp>

#include "sm_c_concrete_states.h"
#include "identifiers.h"

// region InitializeState

InitializeState::InitializeState(Controller& context) : ControllerState(context) {
}

void InitializeState::entry_action() {
  DEBUG_PRINTLN("-- Entered state Initialize");
  controller.set_worker_active(k_worker_mode_button, true);
  controller.set_worker_active(k_worker_controller_state, true);
  controller.set_handler_active(k_handler_controller_handler, true);
  controller.set_handler_active(k_handler_storage_handler, true);
}

void InitializeState::do_activity() {
  controller.initialize();
}

void InitializeState::exit_action() {

}

void InitializeState::handle_event(Event_enum event_id) {
  switch(event_id) {
    case e_c_controller_initialized: {
      controller.set_state(new InitReadingState(controller));
      break;
    }
    default:
      ControllerState::handle_event(event_id);
      break;
  }
}

// endregion

// region InitReadingState

InitReadingState::InitReadingState(Controller& context) : ControllerState(context), _button_pressed(false) {
}

void InitReadingState::entry_action() {
  DEBUG_PRINTLN("-- Entered state Initialize reading");
  controller.set_worker_active(k_worker_bgeigie_connector, true);
}

void InitReadingState::do_activity() {
}

void InitReadingState::exit_action() {

}

void InitReadingState::handle_event(Event_enum event_id) {
  switch(event_id) {
    case e_c_reading_initialized: {
      if(_button_pressed) {
        /// Button pressed during init, go to config mode
        controller.set_state(new ConfigurationModeState(controller));
      } else {
        /// To post init, where the user has 3 seconds to press button to go to config mode
        controller.set_state(new PostInitializeState(controller));
      }
      break;
    }
    case e_c_button_pressed:
      _button_pressed = true;
      break;
    default:
      ControllerState::handle_event(event_id);
      break;
  }
}

// endregion

// region PostInitializeState

PostInitializeState::PostInitializeState(Controller& context) : ControllerState(context), timer(0) {
}

void PostInitializeState::entry_action() {
  DEBUG_PRINTLN("-- Entered state PostInitialize");
  timer = millis();
}

void PostInitializeState::do_activity() {
  if(millis() - timer > POST_INITIALIZE_DURATION) {
    controller.schedule_event(e_c_post_init_time_passed);
  }
}

void PostInitializeState::exit_action() {
}

void PostInitializeState::handle_event(Event_enum event_id) {
  switch(event_id) {
    case e_c_button_pressed:
      /// Button pressed, go to config mode
      controller.set_state(new ConfigurationModeState(controller));
      break;
    case e_c_post_init_time_passed: {
      /// Additional init time has passed, go to previously saved state (fixed or mobile)
      switch(controller.get_saved_state()) {
        case Controller::k_savable_FixedMode:
          controller.set_state(new FixedModeState(controller));
          break;
        case Controller::k_savable_MobileMode:
        default:
          controller.set_state(new MobileModeState(controller));
          break;
      }
      break;
    }
    default:
      ControllerState::handle_event(event_id);
      break;
  }
}

// endregion

// region ConfigModeState

ConfigurationModeState::ConfigurationModeState(Controller& context) : ControllerState(context) {
}

void ConfigurationModeState::entry_action() {
  DEBUG_PRINTLN("-- Entered state ConfigurationMode");
  controller.set_worker_active(k_worker_wifi_access_point, true);
  controller.set_worker_active(k_worker_configuration_server, true);
}

void ConfigurationModeState::do_activity() {

}

void ConfigurationModeState::exit_action() {
  controller.set_worker_active(k_worker_wifi_access_point, false);
  controller.set_worker_active(k_worker_configuration_server, false);
}

void ConfigurationModeState::handle_event(Event_enum event_id) {
  switch(event_id) {
    case e_c_button_pressed:
      /// Button pressed, leave config mode to go to previously saved state (fixed or mobile)
      switch(controller.get_saved_state()) {
        case Controller::k_savable_FixedMode:
          controller.set_state(new FixedModeState(controller));
          break;
        case Controller::k_savable_MobileMode:
        default:
          controller.set_state(new MobileModeState(controller));
          break;
      }
      break;
    case e_c_button_long_pressed:
      controller.set_state(new ResetState(controller));
      break;
    default:
      ControllerState::handle_event(event_id);
      break;
  }
}

// endregion

// region MobileModeState

MobileModeState::MobileModeState(Controller& context) : ControllerState(context) {
}

void MobileModeState::entry_action() {
  DEBUG_PRINTLN("-- Entered state MobileMode");
  controller.save_state(Controller::k_savable_MobileMode);
  controller.set_handler_active(k_handler_bluetooth_reporter, true);
}

void MobileModeState::do_activity() {
}

void MobileModeState::exit_action() {
  controller.set_handler_active(k_handler_bluetooth_reporter, false);
}

void MobileModeState::handle_event(Event_enum event_id) {
  switch(event_id) {
    case e_c_button_pressed:
      controller.set_state(new FixedModeState(controller));
      break;
    case e_c_button_long_pressed:
      controller.set_state(new ResetState(controller));
      break;
    default:
      ControllerState::handle_event(event_id);
      break;
  }
}


// endregion

// region FixedModeState

FixedModeState::FixedModeState(Controller& context) : ControllerState(context) {
}

void FixedModeState::entry_action() {
  DEBUG_PRINTLN("-- Entered state FixedMode");
  controller.save_state(Controller::k_savable_FixedMode);
  controller.set_handler_active(k_handler_api_reporter, true);
  controller.set_worker_active(k_worker_configuration_server, controller._config.get_wifi_server());
}

void FixedModeState::do_activity() {
}

void FixedModeState::exit_action() {
  controller.set_handler_active(k_handler_api_reporter, false);
  controller.set_worker_active(k_worker_configuration_server, false);
}

void FixedModeState::handle_event(Event_enum event_id) {
  switch(event_id) {
    case e_c_button_pressed:
      controller.set_state(new MobileModeState(controller));
      break;
    case e_c_button_long_pressed:
      controller.set_state(new ResetState(controller));
      break;
    default:
      ControllerState::handle_event(event_id);
      break;
  }
}

// endregion

// region ResetState

ResetState::ResetState(Controller& context) : ControllerState(context) {

}

void ResetState::entry_action() {
  DEBUG_PRINTLN("-- Entered state Reset");
}

void ResetState::do_activity() {
  controller.reset_system();
}

void ResetState::exit_action() {

}

void ResetState::handle_event(Event_enum event_id) {
  ControllerState::handle_event(event_id);
}

// endregion
