Safecast/bGeigieCast/bgeigiecast/http_pages.cpp

#include <WebServer.h>
#include "http_pages.h"
#include "user_config.h"
#include "api_connector.h"

#define TITLE_HOME "Home"
#define TITLE_UPDATE "Update firmware"
#define TITLE_STATUS "Status"
#define TITLE_CONF_DEVICE "Configure device"
#define TITLE_CONF_LOCATION "Configure location"
#define TITLE_CONF_CONNECTION "Configure connection"

const char* success_message = "<p><em>Configurations saved!</em></p>";

const char* local_resources =
    "<link rel='stylesheet' href='/pure.css'>";

const char* online_resources =
    "<script src='https://ajax.googleapis.com/ajax/libs/jquery/3.2.1/jquery.min.js'></script>"
    "<link rel='stylesheet' href='https://use.fontawesome.com/releases/v5.8.2/css/all.css' "
    "integrity='sha384-oS3vJWv+0UjzBfQzYUhtDYW+Pj2yciDJxpsK1OYPAYjqT085Qq/1cq5FLXAZQ7Ay' crossorigin='anonymous'>";

const char* fallback_resources =
    "";

const char* update_firmware_script =
    "(e=>{const t=(...t)=>e.querySelector(...t),n=t('form'),a=t('#status');n.addEventListener('submit',e=>{e.prevent"
    "Default();const s=new FormData(n),o=t('#file').files[0],d=new XMLHttpRequest;o?(n.classList.add('uploading'),s."
    "append('update',o),d.addEventListener('load',e=>{a.innerText='Applying update...';setTimeout(()=>{a.innerText='"
    "Upload success! The device is now restarting to apply update.';const t=new XMLHttpRequest;t.open('get','/reboot')"
    ",t.send()},2000)}),d.addEventListener('error',e=>{a.innerText='Upload failed... Try again or contact info@safecast"
    ".org',n.classList.remove('uploading')}),d.addEventListener('abort',e=>{a.innerText='Upload canceled...'}),d.upload"
    ".addEventListener('progress',e=>{if(e.lengthComputable){a.innerText='Uploading new firmware... This can take up t"
    "o 10 minutes.';const n=Math.round(e.loaded/e.total*100)+'%';t('#prg').innerText=n,t('#bar').style.width=n}}),d."
    "open(n.method,n.action),d.send(s)):a.innerText='Please select a file...'})})(this.document);";

/**
 * page format
 * %s - page name (page title)
 * %d - device id (page title)
 * %s - remote resources
 * %s - local resources
 * %d - device id (menu title)
 * %s - page content (main content)
 */
const char* base_page_format_begin =
    "<!DOCTYPE html>"
    "<html lang='en'><head>"
    "<meta name='viewport' content='width=device-width, initial-scale=1.0'>"
    "<title>%s | bGeigieCast %d</title>"
    "%s"
    "%s"
    "<style>"
    "i{width: 25px;text-align: center;}"
    "#layout{max-width: 680px;margin: auto;}"
    "#main{padding:1em;}"
    "input[type='text'],input[type='number']{max-width: 300px;width: 100%%;}"
    ".pure-menu-link{padding: 1em .7em;}"
    "</style>"
    "</head>"
    "<body>"
    "<div id='layout'>"
    "<div id='header'>"
    "<div class='pure-menu pure-menu-horizontal'>"
    "<a href='/' class='pure-menu-heading'>bGeigieCast %d</a>"
    "<ul class='pure-menu-list'>"
    "<li class='pure-menu-item pure-menu-has-children pure-menu-allow-hover'>"
    "<a href='#' id='menuLink1' class='pure-menu-link'><i class='fa fa-cog'></i>Configure</a>"
    "<ul class='pure-menu-children'>"
    "<li class='pure-menu-item'><a href='/device' class='pure-menu-link'><i class='fa fa-tablet'></i>Device</a></li>"
    "<li class='pure-menu-item'><a href='/connection' class='pure-menu-link'><i class='fa fa-wifi'></i>Connection</a></li>"
    "<li class='pure-menu-item'><a href='/location' class='pure-menu-link'><i class='fa fa-map-marker-alt'></i>Location</a></li>"
    "</ul></li>"
    "<li class='pure-menu-item'><a href='/update' class='pure-menu-link'><i class='fa fa-download'></i>Update firmware</a></li>"
    "<!--<li class='pure-menu-item'><a href='/status' class='pure-menu-link'><i class='fas fa-info-circle'></i>Status</a></li>-->"  // TODO: comment this out once status page is done
    "<li class='pure-menu-item'><a target='_blank' href='https://github.com/Safecast/bGeigieCast/' class='pure-menu-link'><i class='fab fa-github'></i>Github</a></li>"
    "</ul>"
    "</div>"
    "</div>"
    "<script>"
    "document.querySelectorAll('.pure-menu-item').forEach((e)=>e.children[0].href===window.location.href?e.classList.add('pure-menu-selected'):0);"
    "</script>"
    "<div id='main'>";

const char* base_page_format_end =
    "</div>"
    "</div>"
    "</body></html>";

const char* HttpPages::get_home_page(uint32_t device_id) {
  return render_full_page(
      device_id,
      TITLE_HOME,
      "<h1>Manage your bGeigieCast</h1>"
      "<p class='pure-form-message'>bGeigieCast version %s</p>"
      "<p>"
      "<ul>"
      "<li><a href='/device'>Configure your device</a></li>"
      "<li><a href='/connection'>Configure your connection to the API</a></li>"
      "<li><a href='/location'>Configure your location for fixed mode</a></li>"
      "<li><a href='/update'>Update the firmware</a></li>"
      "</ul>"
      "More information about configurations in the <a href='https://github.com/Safecast/bGeigieCast/wiki/User-manual#available-settings' target='_blank'>User manual</a>. "
      "Or view your device on <a href='https://grafana.safecast.cc/d/RphzozyGk/safecast-geigiecast-drive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' target='_blank'>Grafana</a>."
      "</p>",
      BGEIGIECAST_VERSION,
      device_id
  );
}

const char* HttpPages::get_update_page(uint32_t device_id) {
  return render_full_page(
      device_id,
      TITLE_UPDATE,
      "<div id='update'>"
      "<form class='pure-form pure-form-stacked' method='POST' enctype='multipart/form-data'>"
      "<fieldset>"
      "<legend><a href='/'>Home</a> / Update the firmware</legend>"
      "<div id='upload-inputs'>"
      "<p><em>Current version: v" BGEIGIECAST_VERSION "</em></p>"
      "<input type='file' name='update' id='file'><br>"
      "<span class='pure-form-message'>The latest firmware can be found on <a target='_blank' href='https://github.com/Safecast/bGeigieCast/tree/development/firmware'>Github</a></span>"
      "<br>"
      "<input type='submit' class='pure-button pure-button-primary' value='Upload'>"
      "</div>"
      "<p id='status'></p>"
      "<div id='upload-progress'>"
      "<div style='background:#eee'><div id='bar' style='background:#ccc;height:10px'></div></div>"
      "<div id='prg' style='text-align:center'></div>"
      "</div>"
      "</fieldset>"
      "</form>"
      "<script>"
      "%s"
      "</script>"
      "<style>"
      "#upload-progress{display:none}"
      "form.uploading #upload-inputs{display:none}"
      "form.uploading #upload-progress{display:block}"
      "</style>"
      "</div>",
      update_firmware_script
  );
}

const char* HttpPages::get_config_device_page(
    bool display_success,
    uint32_t device_id,
    uint8_t led_intensity,
    bool colorblind,
    bool webserver
) {
  return render_full_page(
      device_id,
      TITLE_CONF_DEVICE,
      "<form class='pure-form pure-form-stacked' action='/save?next=/device' method='POST'>"
      "<fieldset>"
      "<legend><a href='/'>Home</a> / Device settings</legend>"

      // Led intensity
      "<label for='" FORM_NAME_LED_INTENSITY "'>Led intensity</label>"
      "<input type='number' min='5' max='100' name='" FORM_NAME_LED_INTENSITY "' id='" FORM_NAME_LED_INTENSITY "' value='%d'>"
      "<span class='pure-form-message'>Value between 5 (very dim) and 100.(very bright).</span>"

      // Colorblind
      "<label>Color set</label>"
      "<label for='" FORM_NAME_LED_COLOR "0' class='pure-radio'>"
      "<input id='" FORM_NAME_LED_COLOR "0' type='radio' name='" FORM_NAME_LED_COLOR "' value='0' %s>Default"
      "</label>"
      "<label for='" FORM_NAME_LED_COLOR "1' class='pure-radio'>"
      "<input id='" FORM_NAME_LED_COLOR "1' type='radio' name='" FORM_NAME_LED_COLOR "' value='1' %s>Colorblind"
      "</label>"
      "<span class='pure-form-message'></span>"

      // Config server access
      "<label>Wifi server</label>"
      "<label for='" FORM_NAME_WIFI_SERVER "0' class='pure-radio'>"
      "<input id='" FORM_NAME_WIFI_SERVER "0' type='radio' name='" FORM_NAME_WIFI_SERVER "' value='0' %s>Disabled"
      "</label>"
      "<label for='" FORM_NAME_WIFI_SERVER "1' class='pure-radio'>"
      "<input id='" FORM_NAME_WIFI_SERVER "1' type='radio' name='" FORM_NAME_WIFI_SERVER "' value='1' %s>Enabled"
      "</label>"
      "<span class='pure-form-message'>You can make this config page available while the device is connected to wifi in fixed mode (access through http://bgeigie%d.local). If disabled, these config pages will only be available in config mode.</span>"

      "<br>"
      "<button type='submit' class='pure-button pure-button-primary'>Save</button>"
      "</fieldset>"
      "</form>"
      "%s", // Success message
      led_intensity,
      colorblind ? "" : "checked",
      colorblind ? "checked" : "",
      webserver ? "" : "checked",
      webserver ? "checked" : "",
      device_id,
      display_success ? success_message : ""
  );
}

const char* HttpPages::get_config_location_page(
    bool display_success,
    uint32_t device_id,
    bool use_home_location,
    double home_latitude,
    double home_longitude,
    double last_latitude,
    double last_longitude
) {
  return render_full_page(
      device_id,
      TITLE_CONF_LOCATION,
      "<form class='pure-form pure-form-stacked' action='/save?next=/location' method='POST'>"
      "<fieldset>"
      "<legend><a href='/'>Home</a> / Location settings</legend>"

      // Use home location
      "<label>Location in fixed mode</label>"
      "<label for='" FORM_NAME_LOC_HOME "0' class='pure-radio'>"
      "<input id='" FORM_NAME_LOC_HOME "0' type='radio' name='" FORM_NAME_LOC_HOME "' value='0' %s>Use GPS"
      "</label>"
      "<span class='pure-form-message'>"
      "Using GPS location: the bGeigieCast will upload measurements to the api using the last measured GPS location."
      "</span>"
      "<label for='" FORM_NAME_LOC_HOME "1' class='pure-radio'>"
      "<input id='" FORM_NAME_LOC_HOME "1' type='radio' name='" FORM_NAME_LOC_HOME "' value='1' %s>Use fixed location"
      "</label>"
      "<span class='pure-form-message'>"
      "Using fixed location: Use a single GPS location as the location for all your measurements. If incoming "
      "measurements are out of range (400+ meter), they will be marked as invalid and will not be send. To use this "
      "setting, the fields below are required."
      "</span>"

      // Home latitude
      "<label for='" FORM_NAME_LOC_HOME_LAT "'>Fixed latitude</label>"
      "<input type='number' min='-90.0000' max='90.0000' name='" FORM_NAME_LOC_HOME_LAT "' id='" FORM_NAME_LOC_HOME_LAT "' value='%.5f' step='0.00001'>"

      // Home longitude
      "<label for='" FORM_NAME_LOC_HOME_LON "'>Fixed longitude</label>"
      "<input type='number' min='-180.0000' max='180.0000' name='" FORM_NAME_LOC_HOME_LON "' id='" FORM_NAME_LOC_HOME_LON "' value='%.5f' step='0.00001'>"

      // Set last known location
      "<span class='pure-form-message'>"
      "Last known location (<a href='#' onclick=\""
      "document.getElementById('" FORM_NAME_LOC_HOME_LAT "').value = document.getElementById('l_la').innerHTML;"
      "document.getElementById('" FORM_NAME_LOC_HOME_LON "').value = document.getElementById('l_lo').innerHTML;"
      "return false;"
      "\">apply</a>):<br>"
      "Latitude: <span id='l_la'>%.5f</span><br>"
      "Longitude: <span id='l_lo'>%.5f</span><br>"
      "</span>"

      "<br>"
      "<button type='submit' class='pure-button pure-button-primary'>Save</button>"
      "</fieldset>"
      "</form>"
      "%s", // Success message
      use_home_location ? "" : "checked",
      use_home_location ? "checked" : "",
      home_latitude,
      home_longitude,
      last_latitude,
      last_longitude,
      display_success ? success_message : ""
  );
}

const char* HttpPages::get_config_connection_page(
    bool display_success,
    uint32_t device_id,
    const char* device_password,
    const char* wifi_ssid,
    const char* wifi_password,
    const char* api_key,
    uint8_t send_frequency,
    bool use_dev
) {
  char ssid[20];
  sprintf(ssid, ACCESS_POINT_SSID, device_id);
  return render_full_page(
      device_id,
      TITLE_CONF_CONNECTION,
      "<form class='pure-form pure-form-stacked' action='/save?next=/connection' method='POST'>"
      "<fieldset>"
      "<legend><a href='/'>Home</a> / Connection settings</legend>"

      // bGeigie ap password
      "<label for='" FORM_NAME_AP_LOGIN "'>bGeigie password</label>"
      "<input type='text' name='" FORM_NAME_AP_LOGIN "' id='" FORM_NAME_AP_LOGIN "' value='%s'>"
      "<span class='pure-form-message'>"
      "The password for the wifi connection access point when starting the bGeigieCast in configuration mode. "
      "The SSID of the bGeigieCast: %s"
      "</span>"

      // WiFi ssid
      "<label for='" FORM_NAME_WIFI_SSID "'>WiFi network name</label>"
      "<input type='text' name='" FORM_NAME_WIFI_SSID "' id='" FORM_NAME_WIFI_SSID "' value='%s'>"
      "<span class='pure-form-message'>Your WiFi network name</span>"

      // WiFi password
      "<label for='" FORM_NAME_WIFI_PASS "'>WiFi password</label>"
      "<input type='text' name='" FORM_NAME_WIFI_PASS "' id='" FORM_NAME_WIFI_PASS "' value='%s'>"
      "<span class='pure-form-message'>Your WiFi network password</span>"

      // Api key
      "<label for='" FORM_NAME_API_KEY "'>API key</label>"
      "<input type='text' name='" FORM_NAME_API_KEY "' id='" FORM_NAME_API_KEY "' value='%s'>"
      "<span class='pure-form-message'>"
      "Get your API key from <a target='_blank' href='https://api.safecast.org'>api.safecast.org</a>, Login -> Dashboard -> Retrieve your API key.<br>"
      "<em>Note: when using development server, get your API key from <a target='_blank' href='https://dev.safecast.org'>dev.safecast.org</a></em>"
      "</span>"

      // Send frequency
      "<label>Send data to server</label>"
      "<label for='" FORM_NAME_SEND_FREQ "0' class='pure-radio'>"
      "<input id='" FORM_NAME_SEND_FREQ "0' type='radio' name='" FORM_NAME_SEND_FREQ "' value='0' %s>Every 5 seconds"
      "</label>"
      "<label for='" FORM_NAME_SEND_FREQ "1' class='pure-radio'>"
      "<input id='" FORM_NAME_SEND_FREQ "1' type='radio' name='" FORM_NAME_SEND_FREQ "' value='1' %s>Every minute"
      "</label>"
      "<label for='" FORM_NAME_SEND_FREQ "2' class='pure-radio'>"
      "<input id='" FORM_NAME_SEND_FREQ "2' type='radio' name='" FORM_NAME_SEND_FREQ "' value='2' %s>Every 5 minutes"
      "</label>"
      "<span class='pure-form-message'>"
      "We suggest sending data every 5 minutes for stationary sensors"
      "</span>"

      // Use dev
      "<label>Safecast server</label>"
      "<label for='" FORM_NAME_USE_DEV "0' class='pure-radio'>"
      "<input id='" FORM_NAME_USE_DEV "0' type='radio' name='" FORM_NAME_USE_DEV "' value='0' %s>Production"
      "</label>"
      "<label for='" FORM_NAME_USE_DEV "1' class='pure-radio'>"
      "<input id='" FORM_NAME_USE_DEV "1' type='radio' name='" FORM_NAME_USE_DEV "' value='1' %s>Development"
      "</label>"
      "<span class='pure-form-message'>"
      "Use development for testing purposes. Double check your API key when changing this option!"
      "</span>"

      "<br>"
      "<button type='submit' class='pure-button pure-button-primary'>Save</button>"
      "</fieldset>"
      "</form>"
      "%s",
      device_password,
      ssid,
      wifi_ssid,
      wifi_password,
      api_key,
      send_frequency == ApiConnector::e_api_send_frequency_5_sec ? "checked" : "",
      send_frequency == ApiConnector::e_api_send_frequency_1_min ? "checked" : "",
      send_frequency == ApiConnector::e_api_send_frequency_5_min ? "checked" : "",
      use_dev ? "" : "checked",
      use_dev ? "checked" : "",
      display_success ? success_message : ""
  );
}

const char* HttpPages::get_status_page(uint32_t device_id) {
  return render_full_page(
      device_id,
      TITLE_STATUS,
      "<form class='pure-form'>"
      "<fieldset>"
      "<legend><a href='/'>Home</a> / Status</legend>"
      "<pre style='background-color:#eee;padding:5px;font-size:12px;max-width:680px'>"
      "bGeigieCast Version %s [%s]<br>"
      " - Current mode: %s<br>"
      "bGeigie data [%s]<br>"
      " - Last data: %s<br>"
      " - Valid: %s<br>"
      "Configuration server [%s]<br>"
      " - Status: %s<br>"
      "Api connection [%s]<br>"
      " - Status: %s<br>"
      "Bluetooth connection [%s]<br>"
      " - Status: %s<br>"
      "</pre>"
      "</fieldset>"
      "</form>",
      BGEIGIECAST_VERSION,
      "Active", // System state
      "Fixed", // - System mode
      "Active", // bGeigie state
      "$BNRDD,2041,2012-09-20T16:53:58Z,776,63,33895,A,5641.7788,N,1411.8820,E,9861.20,A,109,9*46", // - bGeigie data
      "Yes", // - bGeigie datavalid
      "Active", // Server state
      "Connected with wifi", // - Server status
      "Active", // Api state
      "Data posted", // - Api status
      "Inactive", // BT state
      "Idle"  // - BT status
  );
}

const char* HttpPages::render_full_page(uint32_t device_id, const char* page_name, const char* content_format, ...) {
  sprintf(
      transmission_buffer,
      base_page_format_begin,
      page_name,
      device_id,
      local_resources,
      internet_access ? online_resources : fallback_resources,
      device_id
  );

  va_list args;
  va_start(args, content_format);
  vsprintf(
      &transmission_buffer[strlen(transmission_buffer)],
      content_format,
      args
  );
  va_end(args);

  sprintf(
      &transmission_buffer[strlen(transmission_buffer)],
      base_page_format_end
  );

  return transmission_buffer;
}

char HttpPages::transmission_buffer[] = "";

const char* HttpPages::pure_js =
    "(function (w,d){const a='active',l=d.getElementById('layout'),m=d.getElementById('menu'),n=d"
    ".getElementById('menuLink'),c=d.getElementById('main'),tc=(e,b)=>{const r=e.className.split("
    "/\\s+/),p=r.length;let i=0;while (i < p){if(r[i]===b){r.splice(i,1);break;}i++;}if(i===p){r."
    "push(b);}e.className=r.join(' ');},ta=(e)=>{e.preventDefault();tc(l,a);tc(m,a);tc(n,a);};n.o"
    "nclick=(e)=>ta(e);c.onclick=(e)=>m.className.indexOf(a)!==-1 && ta(e);}(this,this.document));";

/**
 *
 */
bool HttpPages::internet_access = false;

/**
 * Gzipped pure css library
 * https://purecss.io/
 */
const uint8_t HttpPages::pure_css[PURE_CSS_SIZE] = {
    0x1f, 0x8b, 0x08, 0x08, 0x56, 0xa2, 0xec, 0x5c, 0x00, 0x03, 0x70, 0x75, 0x72, 0x65, 0x2d, 0x6d,
    0x69, 0x6e, 0x2e, 0x63, 0x73, 0x73, 0x00, 0xed, 0x1b, 0x6b, 0x8f, 0xe3, 0xb6, 0xf1, 0xfb, 0xfd,
    0x0a, 0xe5, 0x0e, 0x07, 0xdc, 0x1e, 0x24, 0xaf, 0x2c, 0x3f, 0x57, 0x42, 0x82, 0x26, 0xcd, 0xa5,
    0x4d, 0x91, 0x06, 0x05, 0xd2, 0x2f, 0xc5, 0x65, 0x0b, 0xd0, 0x12, 0x6d, 0xab, 0xab, 0x17, 0x24,
    0x79, 0x1f, 0xe7, 0xfa, 0xbf, 0x77, 0xf8, 0x90, 0x34, 0x7c, 0xc8, 0xf6, 0xa6, 0x45, 0xd1, 0x0f,
    0x8d, 0x73, 0x77, 0x12, 0x39, 0x1c, 0x0e, 0xe7, 0xc5, 0x99, 0x21, 0x75, 0xfb, 0xf1, 0xab, 0x37,
    0x7f, 0x39, 0xd4, 0xd4, 0x79, 0x9c, 0x4e, 0xfc, 0x89, 0xff, 0xe6, 0xf7, 0x65, 0xf5, 0x52, 0xa7,
    0xbb, 0x7d, 0xeb, 0x04, 0xfe, 0x74, 0xe6, 0xfc, 0x8d, 0xec, 0xcb, 0xf2, 0xab, 0x37, 0x3f, 0xa5,
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
    0x02, 0x21, 0x25, 0x76, 0xb6, 0xb7, 0xb0, 0xb9, 0xb1, 0x0e, 0x08, 0x01, 0xc7, 0x71, 0xe0, 0x38,
    0x0e, 0x00, 0xc0, 0xb2, 0x2c, 0x00, 0x80, 0x6d, 0xdb, 0x07, 0x2b, 0x08, 0xa9, 0xf0, 0x6e, 0xf6,
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
};
