Safecast/bGeigieCast/bgeigiecast/identifiers.h

#ifndef BGEIGIECAST_IDENTIFIERS_H_
#define BGEIGIECAST_IDENTIFIERS_H_

/**
 * The worker identifiers in the system
 */
enum DataWorkers {
  k_worker_bgeigie_connector = 0,
  k_worker_controller_state,
  k_worker_configuration_server,
  k_worker_wifi_access_point,
  k_worker_mode_button,
};

/**
 * The handler identifiers in the system
 */
enum DataHandlers {
  k_handler_controller_handler = 0,
  k_handler_storage_handler,
  k_handler_bluetooth_reporter,
  k_handler_api_reporter,
};

#endif //BGEIGIECAST_IDENTIFIERS_H_
