Safecast/bGeigieCast/bgeigiecast/bluetooth_connector.h

#ifndef BGEIGIECAST_BLUETOOTH_CONNECTOR_H
#define BGEIGIECAST_BLUETOOTH_CONNECTOR_H

#include <BLEDevice.h>

#include "bluetooth_connector.h"
#include "bluetooth_settings.h"
#include "reading.h"

/**
 * Setups up bluetooth endpoint for the device, allowing it to send readings over bluetooth
 */
class BluetoohConnector {
 public:
  BluetoohConnector();
  virtual ~BluetoohConnector() = default;

  /**
   * Initialize the bluetooth, using device id as name
   * @param device_id : id of the bgeigie device
   */
  virtual bool init(uint16_t device_id);

  /**
   * Send a new reading over bluetooth
   * @param reading : reading object to send
   */
  virtual bool send_reading(Reading& reading);
 private:
  void create_ble_profile_service(BLEServer* pServer);
  void create_ble_device_service(BLEServer* pServer);
  void create_ble_data_service(BLEServer* pServer);

  BLEServer* pServer;
  bool initialized;
  BLECharacteristic* pDataRXCharacteristic;

  uint8_t addr[BLE_DATA_ADDR_SIZE] = BLE_DATA_ADDR;

};

#endif //BGEIGIECAST_BLUETOOTH_CONNECTOR_H
