Safecast/bGeigieCast/bgeigiecast/conf_server.h

#ifndef BGEIGIECAST_SERVER_H
#define BGEIGIECAST_SERVER_H

#include <WiFi.h>
#include <WebServer.h>

#include "esp_config.h"

/**
 * Class to host a web server for configuring the ESP32. Will set up an access
 * point based on user_config.h "Access point settings".
 */
class ConfigWebServer {
 public:
  explicit ConfigWebServer(EspConfig& config);
  virtual ~ConfigWebServer();

  /**
   * Initialize the web server, does nothing if it is already initialized.
   * @return true if initialization was success
   */
  bool connect(bool try_wifi = true);

  /**
   * Stop the web server
   */
  void stop();

  /**
   * Checks if there are requests and handles them
   */
  void handle_requests();

  /**
   * Initialize the web server and endpoints
   */
  void start_server();

  /**
   * if the server is running
   */
  bool running() const;
 private:

  /**
   * Try to connect to the wifi
   * @return success
   */
  bool connect_wifi();

  /**
   * Start access point server
   * @return success
   */
  bool start_ap_server(const char* host_ssid);

  /**
   * Handles request for `/save`
   */
  void handle_save();

  /**
   * Handles request for `/update` post
   */
  void handle_update_uploading();

  WebServer _server;
  EspConfig& _config;

  bool _running;
};

#endif //BGEIGIECAST_SERVER_H
