Safecast/bGeigieCast/(commit log)

2019-02-14 Added Kicad files
    [Xbee ESP32.kicad_pcb, xbee.brd, xbee.kicad_pcb, xbee.sch]
2019-02-22 add rest of the states; add button functionality
2019-02-24 move webserver to temp, fix compile warning in config
    [esp_config.cpp, esp_config.h, webserver.cpp]
2019-02-25 add all state transitions, add connect to wifi, fix small button issue with pressing on startup
    [api_connector.cpp, api_connector.h, controller.cpp, controller.h, esp_config.cpp, main.cpp]
2019-02-25 move around source files to compile on arduino, (not compiling yet, but still works in PIO
2019-02-25 Revert "move around source files to compile on arduino, (not compiling yet, but still works in PIO"
    This reverts commit 66b7ec96b2d00c78c572f4088980267880817d16.
    [api_connector.cpp, api_connector.h, controller.cpp, controller.h, esp_config.cpp, esp_config.h, main.cpp]
2019-02-25 fix typo in schedule_event
    [controller.cpp]
2019-02-27 update button test
2019-02-27 Updated Kicad files
    [xbee.dsn, xbee.kicad_pcb, xbee.sch]
2019-02-27 Added screenshot of board
2019-03-01 fix precision parse, is now precision + checksum; update unit test
    [reading.cpp, reading.h]
2019-03-01 fix float unit test in json
    [reading.cpp]
2019-03-01 first reading from bGeigie parsed through Serial2 (pin 16 17)
2019-03-04 add bluetooth connector class, initial settings etc
2019-03-05 quick fix button unit tests
2019-03-05 managed to connect to ESP32 bluetooth with android app
2019-03-06 add hardware designs to development
    [xbee.dsn, xbee.kicad_pcb, xbee.sch]
2019-03-06 add reading str back to reading class; send reading object ot bluetooth; init bluetooth on first reading to report; bluetooth init with reading device id;
2019-03-07 add api connector methods; change reading parameter from pointer to reference;
2019-03-08 add rgb led things for state changes
2019-03-08 add a test, rename esp led to rgb led
2019-03-08 fix small builtin led test include, add the rgb led test to ignore by default
    [test_builtin_esp_led.cpp]
2019-03-09 working interrupt on mode button
2019-03-09 add post init state, start server now on button press after startup (in post init state), fix some button issues
2019-03-10 move blink to mode led, change led colors for connecting and active, add initial parameter for api connect
2019-03-11 fix button unit test, fix initial state unit test
2019-03-11 fix api host define
    [api_connector.cpp]
2019-03-12 fix else statements in esp config; add ap configurations to config server; fix success message
    [esp_config.cpp]
2019-03-12 Added new board Gerber files
    [xbee-B_Mask.gbs, xbee-B_Paste.gbp, xbee-B_SilkS.gbo, xbee-Bottom.gbl, xbee-Edge_Cuts.gbr, xbee-F_Mask.gts, xbee-F_Paste.gtp, xbee-F_SilkS.gto]
2019-03-13 fix api endpoint, add check for correct http begin
    [api_connector.cpp]
2019-03-13 add check for correctly parsed reading before process
    [controller.cpp, reading.cpp, reading.h]
2019-03-13 reading only valid if device id > 0, log bluetooth name;
2019-03-13 add some rgb led logic for anode types
2019-03-19 redo request query param getter; add variable for esp32 preference begin
2019-03-19 update unit tests, fix issue in esp config to set init state
    [esp_config.cpp, esp_config.h]
2019-03-26 more injector patterns, cleanup code, change time checks to handle millis rollover, add stability check but needs final changes (used a custom time function before but didnt like it)
    [api_connector.cpp, api_connector.h, bgeigie_connector.cpp, bgeigie_connector.h, controller.cpp, controller.h]
2019-03-26 add injector for api connector, bluetooth connector. update state machine tests.
2019-03-26 fix lat / long conversion issue, add test for dms to dd conversion,
    [reading.cpp]
2019-03-28 add LED config; update webserver to display led config and save on submit
2019-03-28 implement intensity in the RGBLed class, fix reversed checked value for led color type
    [controller.cpp, state_led.cpp, state_led.h]
2019-03-28 add color blind logic to the state led class
2019-03-28 shorten key name for intensity configuration
    [esp_config.cpp]
2019-03-28 update default LED intensity from 200 to 75
2019-04-17 update designs
    [Xbee ESP32.kicad_pcb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]
2019-04-17 move hardware to designs, rename diagrams to software, update software desgins
    [Xbee ESP32.kicad_pcb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]
2019-04-19 make it arduino IDE compilable
2019-04-22 fix some transitions and add event schedules to the send reading to api
    [api_connector.cpp]
2019-04-30 fix debugger when disabled, add default env
    [bluetooth_connector.cpp, bluetooth_connector.h]
2019-05-01 fix check from to ; save only reading that are 100% valid
    [api_connector.cpp, reading.h]
2019-05-01 some small changes, if api report failed it will stay in connection error now, updated the LED colors
    [api_connector.cpp, controller.cpp, sm_events.h, state_led.cpp]
2019-05-01 fix issue stuck in api failed state, update the sleep things
    [bgeigiecast.ino]
2019-05-02 remove access point ssid from config, add device id to config, add controller state init reading (between init and post init), add reporter init state to get the initial reading
2019-05-07 fix gps precision (bgeigie uses decimal minutes, not minutes seconds), update blink rate
    [api_connector.cpp, button.cpp, button.h, controller.cpp, reading.cpp, state_led.cpp]
2019-05-13 add 'use current location' to conf page
2019-05-13 save last location in memory instead of resetting it on startup...
    [esp_config.cpp, esp_config.h]
2019-05-13 renamed controller event reporter done, fixed unhandled event message
    [controller.cpp, esp_config.cpp, sm_events.h]
2019-05-13 move conf page data to own file; fix gps precision issue; add method to apply home location to reading, revalidating it;
    [conf_server.cpp, http_pages.h, reading.cpp, reading.h]
2019-05-14 fix client stuck for real this time
    [conf_server.cpp, http_pages.h]
2019-05-14 update blinking function in state led, initializing now blinks every second (0.1 sec on, 0.9 sec off)
2019-05-15 rename state led to mode led, so it doesnt confuse with the state machine files
2019-05-15 remove unused methods, remove old debug lines, fix LED turn off
    [conf_server.cpp, rgb_led.cpp]
2019-05-15 fix button things, move button observer to button file
    [button.cpp, button.h, controller.h]
2019-05-15 Added V1.2.0 gerber files
    [xbee-B_Mask.gbs, xbee-B_Paste.gbp, xbee-B_SilkS.gbo, xbee-Bottom.gbl, xbee-Edge_Cuts.gko, xbee-F_Mask.gts, xbee-F_Paste.gtp, xbee-F_SilkS.gto]
2019-05-15 Added BOM
    [BOM.csv]
2019-05-16 fix reading issue, now actually sends the merged reading instead of the last one. also fixed the printf debug macro
    [reading.cpp, reading.h]
2019-05-17 make flow diagram smaller and increase text size so it fits on the github wiki
2019-05-17 update led intensity
2019-05-17 fix intensity > 100 in rgb led
    [rgb_led.cpp]
2019-05-27 fix saving config, cleaned up http pages
    [conf_server.cpp, http_pages.cpp, http_pages.h]
2019-06-07 fix segfault in rendering full config page, update update and other scripts (no longer requires jquery)
    [conf_server.cpp, http_pages.cpp, http_pages.h]
2019-06-17 fix critical error in the page rendering
    [http_pages.cpp]
2019-06-17 update button tests
2019-06-17 add dm_to_dd to lib tests, fix 2 mistakes in the reading tests
    [reading.cpp]
2019-06-17 update post init time to 4 seconds, add bGeigieCast version to landing page of conf server
2019-06-17 add some information on the landing page
2019-06-19 create conf server tests, update conf server startup sequence (required for testing), update test connectors
2019-12-07 fix led intense flash on startup
    [sm_c_concete_states.cpp]
2019-12-29 work in progress, restructured everything, missing led output and correct state transitions for controller
    [configuration_server.h]
2019-12-29 add led defines
2019-12-30 fix configuration server wifi connection, calm down the led changes
    [configuration_server.h]
2019-12-30 config mode will now always use the access point, make config server available in fixed mode through wifi (if connected).
    [configuration_server.h]
2019-12-30 add reset reading in api reporter activation
    [api_connector.cpp]
2019-12-30 minor changes in html pages (breadcrubs to home, fix small inconvinience in the update script)
    [configuration_server.cpp, http_pages.cpp]
2019-12-30 fix bluetooth advertising, currently unable to de-initialize so bt stays on (but not handled in fixed mode)
    [bluetooth_reporter.cpp, bluetooth_reporter.h, http_pages.cpp]
2020-01-04 implementing the state transition to reset on long button press
    [sm_c_concete_states.cpp]
2020-01-04 optimize config server, updating OTA, fix state transition out of config mode
    [configuration_server.cpp, http_pages.cpp, sm_c_concete_states.cpp, wifi_connection.cpp]
2020-07-26 Wireless charger dock for QI
2020-10-03 updated files
    [BOM bGeigieCast.csv, BOM bGeigieCast.xls, Xbee ESP32.kicad_pcb, bGeigieCast_V1.4.0.kicad_pcb, bGeigiecast.FCStd, xbee BOM.xlsx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]
2020-10-07 Updated BOM
    [BOM bGeigieCast.csv, BOM bGeigieCast.xlsx]
2021-04-10 Added bGigeiCast files to be implemented
    [BOM bGeigieCast.xlsx, bGeigieCast_V1.4.0.kicad_pcb, bGeigieCast_V1.4.0.kicad_sch, xbee.kicad_pcb, xbee.kicad_sch]
2021-06-22 V1.5.0 with ESP32-C3
    [BOM bGeigieCast.csv, BOM bGeigieCast.xls, BOM bGeigieCast.xlsx, Xbee ESP32.kicad_pcb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]
2021-06-23 Update V1.5.0 board
    [bGeigieCast V1.5.kicad_pcb, xbee.FCStd, xbee.step, xbee1.step]
2021-06-28 some updates
    [configuration_server.h]
2021-06-28 fixed home location calculation and usage
    [api_connector.cpp, reading.cpp]
2023-06-27 add additional gps checks for measurements, add config server option to disable in fixed mode, fix response handle code
    [api_connector.cpp, api_connector.h, bgeigiecast.ino, configuration_server.cpp, http_pages.cpp, http_pages.h, local_storage.cpp, local_storage.h]
2023-06-28 add LED support for gps errors (blink red) / sensor errors (solid red); cleanup code;
    [api_connector.cpp, api_connector.h, mode_led.cpp, reading.cpp, reading.h]
2023-07-28 d V1.6.0 boards
    [BOM bGeigieCast.csv, BOM bGeigieCast.xls, BOM bGeigieCast.xlsx, ESP-07v2.stl, ESP-07v2_4wings.stl, ESP-12.stl, ESP-12E.stl, ESP-12E_4wings.stl]
2023-09-07 Added V1.6.2 Gerbers and many boards updates.
    [8Z40000017, TXC, Crystal Resonator, 40 MHz, M5Stamp C3.SLDPRT, ANT1, PRO-OB-440, M5Stamp-C3.SLDPRT, CH9102F, USB Serial Port Chip, M5Stamp C3.SLDPRT, Cover, M5Stamp-C3.SLDPRT, ESP32­C3 Microcontroller, M5Stamp-C3.SLDPRT, F1, 500 mA Fuse, M5Stamp-C3.SLDPRT, Fastening Press Fit Nut, M5Stamp-C3.SLDPRT, Female USB Type C Connector, M5Stamp-C3.SLDPRT]
2025-09-25 fix: add missing stdint header and resolve merge conflict in pin definitions
    [circular_buffer.h]
